kiarash-rgr/Two-Stage-Gearbox-Shaft-Design/final MED project report.pdf

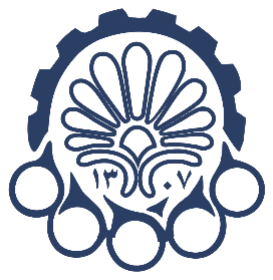
[picture p1: figure]

### دانشگاه صنعتی امیر کبیر )پلی تکنیک تهران(

## پروژهی درس طراحی اجزا :1

### طراحی شفت

استاد: دکتر علی عظیمی
تدریس یار: دکتر مازیار عسکری

گردآورندگان:
ماهک مهدی پور
40226084
کیارش روی گر
40226406
تاریخ تحویل:
1404/11/18

نیمسال اول سال تحصیلی ) 1404-1405(

فهرست مطالب
طرح مسئله 6 |
محاسبات شفت چهارم | 2⁵

فهرست شکلها

شکل -7 نمودار های ممان خمشی و برش در نرم افزار متلب | ۱⁵
شکل -8 layout اولیه از شکل کلی شفت با رعایت تثبیت کننده ها | ۱⁵
شکل -15 نمای کلی نیرو های وارده بر شفت شماره چهار | 2⁵
شکل -27 نقشه فریم بیس | 4⁵

فهرست جداول

جدول -17 نیرو های وارده بر شفت چهار | 2⁵

## طرح مسئله

در پروژههای صنعتی و ساختمانی، سیستم های باالبر نقش اساسی در جابهجایی عمودی بار با ایمنی و قابلیت اطمینان باال
ایفا میکنند. طراحی صحیح اجزای مکانیکی این سیستمها، بهویژه شفت ها و مجموعه انتقال قدرت، تأثیر مستقیمی بر عملکرد، عمر کاری و ایمنی کل سامانه دارد. ازاینرو، تحلیل مهندسی دقیق بارگذاری ها، انتخاب مناسب اجزا و رعایت معیارهای طراحی استاتیکی و خستگی، از الزامات اساسی در فرآیند طراحی محسوب میشود.

در این پروژه، یک باالبر ساختمانی در شرایط پایا مورد بررسی قرار میگیرد که وظیفه انتقال عمودی بار را با سرعت ثابت ۳۳ متر بر ثانیه بر عهده دارد. بار منتقلشده شامل 225 عدد آجر با جرم 2 کیلوگرم برای هر آجر است. توان مورد نیاز این سامانه توسط یک الکتروموتور با سرعت نامی 1600 دور بر دقیقه تأمین شده و از طریق یک سیستم انتقال قدرت شامل چهار شفت، سه جفت چرخ دنده و یک پولی به کابل باالبر منتقل میشود.

هدف اصلی این پروژه، طراحی مهندسی شفتها و اجزای مرتبط در سیستم انتقال قدرت باالبر است؛ بهگونه ای که ضمن تأمین توان و گشتاور مورد نیاز، الزاماتس استحکام، خستگی، ایمنی و قابلیت ساخت نیز برآورده شوند. در این راستا، محاسبه توان مورد نیاز، تحلیل نیروها و گشتاورها، تعیین مقاطع بحرانی شفتها، انتخاب قطر مناسب بر اساس معیارهای طراحی، و در نهایت ارائه نقشه های ساخت و مدلهای CAD از جمله مراحل اساسی این پروژه به شمار میآیند.

## اطالعات تکمیلی مسئله

- در این گیربکس از چرخدنده های ساده )gear spur )با زاویه فشار 20 درجه استفاده شده است.
- بلبرینگ ها از نوع groove deep و از سری 02 میباشند
- جنس شفت از نوع Drawn Cold 1040 AISI با سطح نهایی ماشینکاری است.
- طراحی خستگی و محاسبه قطر های نقاط بحرانی با معیار سادربرگ

1
و ضریب اطمینان اولیه ۳ انجام شده است.
- محاسبه قطر های نقاط بحرانی با استفاده از تحلیل استاتیکی با معیار ترسکا

2
با ضریب اطمینان ۳ انجام شده است.
- ضریب اطمینان مورد نیاز در نقاط جاخار برابر 4 میباشد.
- مقادیر 1L و 2L مشخص شده در شکل 1 به ترتیب : 270 و 1۳0 میلی متر است.

جدول -1 ابعاد چرخدندهها
| | چرخدنده قطر)mm )پهنا )mm )
30 | 50 | G1
30 | 200 | G2
35 | 60 | G3
35 | 150 | G4
40 | 70 | G5
40 | 280 | G6

1 Soderberg
2 Tresca

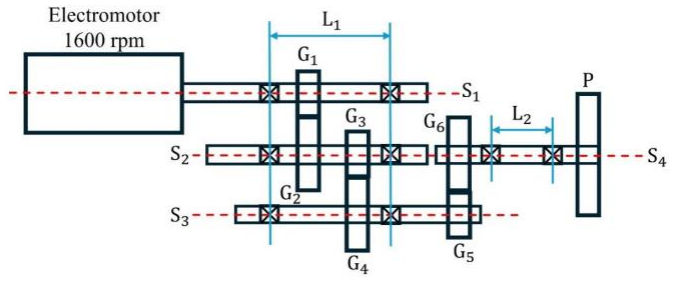
[picture p2: figure]

شکل -1 طرح کلی سیستم انتقال قدرت )نما از باالی سیستم(

## محاسبات اولیه

محاسبه قطر پولی

DG1

=50 mm ; DG2

=200 mm ; DG3

=60 mm ; DG4

=150 mm ; DG5

=70 mm ; DG6

=280 mm

wS1

=1600 rpm

wS2

= wS1

×

DG1
DG2

→ wS2

= 400 rpm

wS3

= wS2

×

DG3
DG4

→ wS3

=160 rpm

wS4

= wS3

×

DG5
DG6

→ wS4

= 40 rpm

v= r×w
v= 0.347 , wS4= 40 rpm

rpulley=

v
w

→ Dpulley=165.5 mm

محاسبه توان الکترو موتور

F= N × m × g = 225 × 2 × 9.81= 4414.5 N

TS4

= F×

D
2

→ TS4
= 365.52 Nm

TS3

= TS4

×

DG5
DG6

→ TS3

= 91.38 Nm

TS2

=TS3

×

DG3
DG4

→TS2

=36.55 Nm

TS1 = TS2
×

DG1
DG2

→ TS1 = 9.138 Nm

P= Tw
Pmotor= 9.138×1600×2×

π
60

→ Pmotor=1.53 Kw

## محاسبات نهایی

محاسبات شفت اول

ϕ=20◦ , DG1

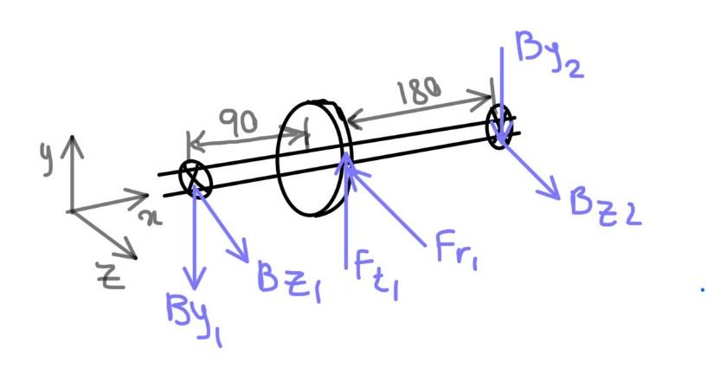
[picture p3: figure]

=50 mm , TS1
= 9.138 Nm

Ft1×

DG1
2

= TS1 → Ft1 = +365.52 N

Fr1 = Ft1×tanφ → Fr1 = −133.04 N

∑Mz = Ft1
× 90 - By2

× 270 = 0 → By2

= -121.84 N

∑My= Fr1
× 90 - Bz2

× 270 = 0 → Bz2
= +44.347 N

∑Fz = -Fr1
+ Bz2

+ Bz1

= 0 → Bz1

= +88.693 N

∑Fy = -By2
+ Ft1
- By1

= 0 → By1

= -243.68 N

جدول -2 نیرو های وارده بر شفت یک

| X(N) | Y(N) | Z(N)
B1 | 0 | -243.68 | +88.693
G1 | 0 | +365.52 | -133.04
B2 | 0 | -121.84 | +44.347

شکل -2 نمای کلی ن یرو های وارده بر شفت شماره ی ک

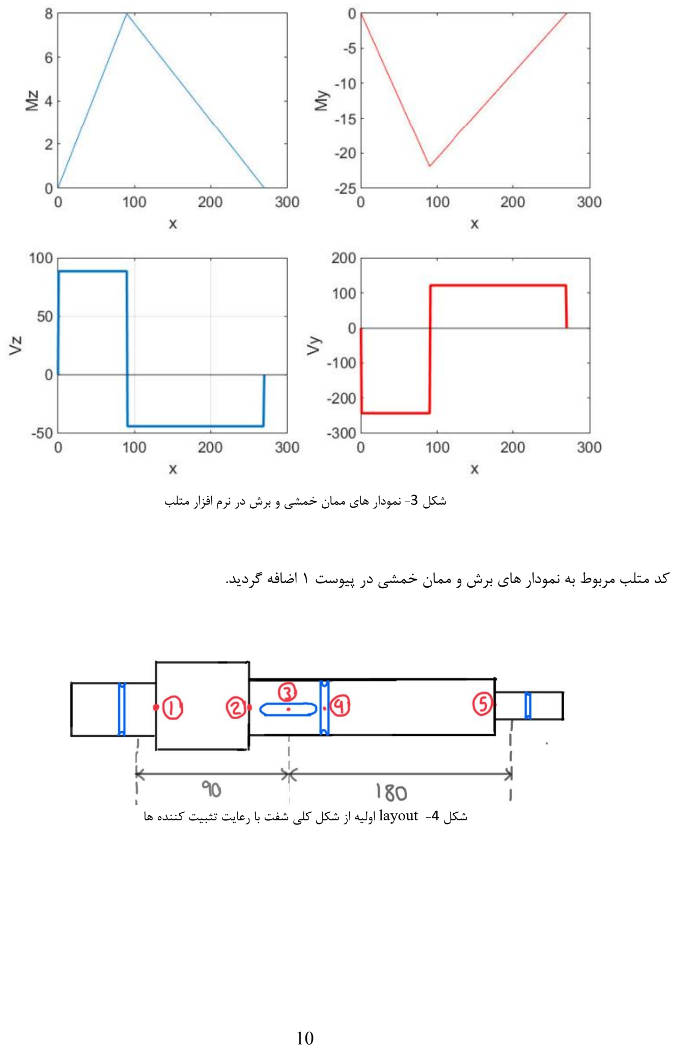
[picture p4: page 10]

کد متلب مربوط به نمودار های برش و ممان خمشی در پیوست 1 اضافه گردید.

شکل -3 نمودار های ممان خمشی و برش در نرم افزار متلب

شکل -4 layout اولیه از شکل کلی شفت با رعایت تثبیت کننده ها

- محاسبه قطر نقاط بحرانی با معیار سادربرگ 3جدول
x(mm) | My (Nm) | Mz (Nm) | Ma (Nm) | Tshaft1 (Nm) | kb | Se (MPa) | D (mm) | d final (mm)
10 | -2.43678 | 0.886667 | 2.59308 | 9.138 | 0.9 | 179.8093 | 12.20333 | 25
75 | -18.2758 | 6.65 | 19.4481 | 9.138 | 0.9 | 179.8093 | 19.74031 | 25
90 | -21.931 | 7.98 | 23.33772 | 9.138 | 0.9 | 179.8093 | 19.98505 | 25
105 | -20.1034 | 7.315 | 21.39291 | 9.138 | 0.9 | 179.8093 | 20.01299 | 25
260 | -1.09655 | 0.399 | 1.166886 | 9.138 | 0.9 | 179.8093 | 10.97021 | 20

جدول -4 محاسبه نقاط بحرانی با معیار ترسکا
x(mm) | My (Nm) | Mz (Nm) | Ma (Nm) | Tshaft1 (Nm) | d (mm)
10 | -2.43678 | 0.886667 | 2.59308 | 9.138 | 8.399846
75 | -18.2758 | 6.65 | 19.4481 | 9.138 | 11.02673
90 | -21.931 | 7.98 | 23.33772 | 9.138 | 11.60716
105 | -20.1034 | 7.315 | 21.39291 | 9.138 | 11.32234
260 | -1.09655 | 0.399 | 1.166886 | 9.138 | 8.314503
3 | در مرحله محاسبه قطر نقاط بحرانی برای محاسبه Se نیاز به تکرار محاسبات
هست که برای این منظور کد پایتون مورد استفاده
در پیوست 1ضافه گردید.
4 | با توجه به ابعاد قطر نهایی بعنوان بیرینگ
اول با مراجعه به استانداد کتاب شیگلی و همچنین SKF بیرینگ با سایز 25 میلی متر
انتخاب شده. با توجه به سایز بیرینگ قطر پله مناسب )قطر ناحیه بین نقطه 1و2( ۳0 میلی متر خواهد بود. برای بیرینگ دوم بیرینگ سایز 20 انتخاب شده که پله مناسب این نوع برابر با 25 میلی متر بوده که با قطری که درنظر گرفتیم مطابقت دارد.

محاسبه مجدد ضریب اطمینان با توجه به قطر های نهایی:

جدول -5 محاسبه مجدد ضریب اطمینان

d final (mm) | sigma a' | sigma m' | 1/nd | nd
25 | 3.46713 | 9.54891 | 0.035467 | 28.19534
25 | 26.00347 | 9.54891 | 0.160802 | 6.218847
25 | 31.20417 | 9.54891 | 0.189725 | 5.27079
25 | 28.60382 | 9.54891 | 0.175263 | 5.705704
20 | 3.047282 | 18.65022 | 0.048558 | 20.594

3
Iteration
4 Bearing

با توجه به قطر بدست آمده برای نقاط بحرانی شفت اول، اندازه جای خار چرخدنده بصورت زیر محاسبه می شود:

قطر شفت در نقطه ای که جاخار چرخدنده قرار می گیرد برابر 25 میلی متر است. با مراجعه به استاندارد مشخصات جاخار:

w=8 mm , h=7 mm , T1=9.138 Nm , d=25 mm , Sy= 490 MPa , Su= 590 MPa

Ls=

4T.nd
wd.Sy

= 1.23 mm

Lp=

4T.nd

hd.Sy, min

= 1.705 mm

با مراجعه به استاندارد، کمترین طول جاخار با توجه به قطر شفت برابر 18 میلیمتر خواهد بود پس طول کلی جاخار به صورت زیر محاسبه خواهد شد.

Ltotal= Lmin+ w = 18+8 = 26 mm
پهنای چرخدنده اول ۳0 میلی متر بوده که بزرگتر از طول جاخار محاسبه شده است و در نتیجه نیازی به اضافه کردن نافی نیست.

اطالعات مربوط به خار فنری:

جدول 6 - مشخصات خارفنری های انتخاب شده
| | | | خار فنری خار فنری جای خار فنری جای خار فنری
d1 | m | d2 | s | d2
20 | 1.3 | 19 | 1.2 | 16.5
25 | 1.3 | 23.9 | 1.2 | 23.2
30 | 1.3 | 28.6 | 1.5 | 27.9

در شکل 5 طراحی شفت شماره 1 با توجه به محاسبات انجام شده مربوط به قطر های نهایی و محاسبات مربوط به جای خار ها، توسط نرم افزار works solid مشاهده می شود. در این شکل محل قرارگیری چرخدنده ها با رنگ آبی و محل قرار گیری بیرینگ ها با رنگ سیاه مشخص شده است. در این طراحی بیرینگ ها بصورت پرسی جا رفته و تثبیت محوری بیرینگ ها و همچنین چرخدنده ها از یک طرف با تکیه بر پله و از طرف دیگر با استفاده از خارفنری، انجام می شود . برای انتخاب سایز بیرینگ و همچنین ارتفاع پله ها از جدول 24 استاندارد سایز بیرینگ که در پیوست 2 آورده شده، استفاده شده است. استاندارد مربوط به ابعاد جای خار فنری و همچنین جای خار مستطیلی به ترتیب در جدول 25 و جدول 26 آورده شده اند که با توجه به قطر در هر قسمت شفت از این استاندارد ها استفاده شده است. با توجه به فرض انجام شده ضمن حل مسئله و انجام محاسبات برای شعاع فیلت ها در هر قسمت نسبت

r
d

0.02= رعایت شده و بر همین اساس طراحی شده اند.

نقشه طراحی شفت 1 در نرم افزار سالید ورک و توضیحات مربوط به تلرانس گذاری به پیوست ۳ اضافه گردید.

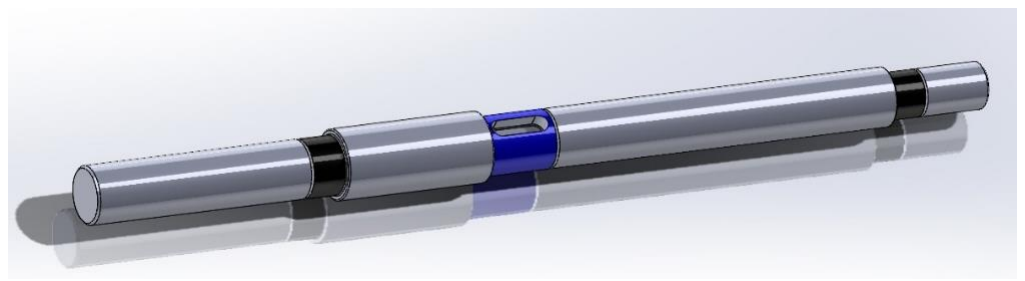
[picture p5: figure]

شکل -5 طراحی نهایی شفت اول در نرم افزار works solid

محاسبات شفت دوم

ϕ= 20◦ , DG3

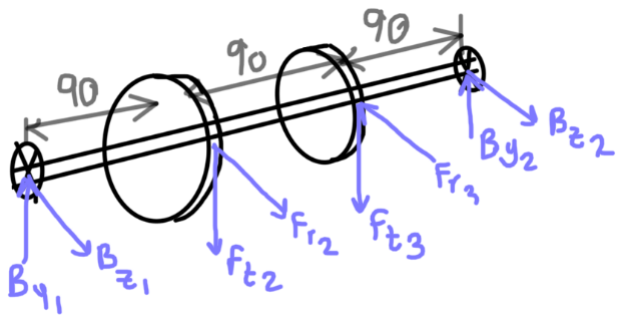
[picture p6: figure]

= 60 mm , Ts2

= 36.55 Nm , Ft2

= -365.52 , Fr2

=+133.04

Ft3

×

DG3
2

= Ts2

→ Ft3

= -1218.33 N

Fr3

=Ft3

×tan(ϕ) → Fr3
= -443.436 N

∑Mz= -Ft2
× 90 - Ft3

× 180 + By2

×270 = 0 → By2

= + 934.06 N

∑My= Fr2
× 90 + Fr3

×180 - Bz2

×270 = 0 → Bz2

= + 251.277 N

∑Fz= +Fr2
+Bz2

+ Bz1

- Fr3

= 0 → Bz1

= +59.119 N

∑Fy = +By2
- Ft2

+ By1

- Ft3

=0 → By1

= +649.79 N

جدول 7 - ن یرو های وارده بر شفت دو

| X(N) | Y(N) | Z(N)
B1 | 0 | +649.79 | +59.119
G2 | 0 | -365.52 | +133.04
G3 | 0 | -1218.33 | -443.436
B2 | 0 | +934.06 | +251.277

شکل -6 نمای کلی ن یرو های وارده بر شفت شمار ه دو

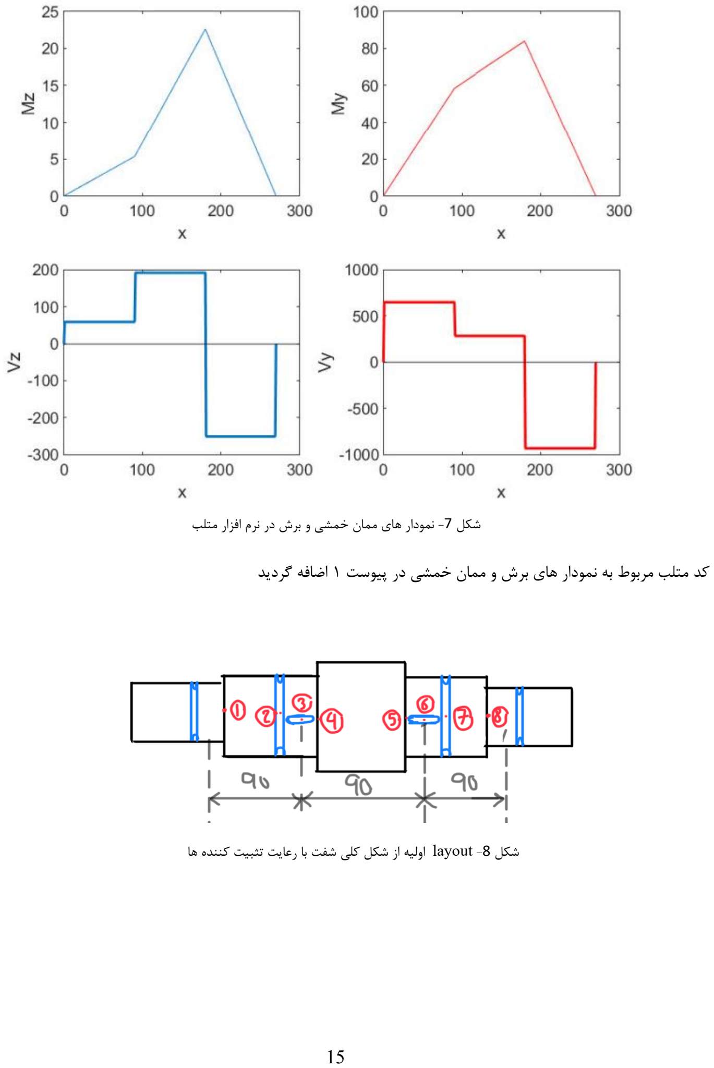
[picture p7: page 15]

کد متلب مربوط به نمودار های برش و ممان خمشی در پیوست 1 اضافه گردید

شکل -8 layout اولیه از شکل کلی شفت با رعا یت تثبیت کننده ها

شکل -7 نمودار های ممان خمشی و برش در نرم افزار متلب

جدول -8 محاسبه قطر نقاط بحرانی بر اساس معیار سادربرگ
x (mm) | My (Nm) | Mz (Nm) | Ma (Nm) | Tshaft2 (Nm) | kb | Se (MPa) | d (mm) | dfinal(mm)
10 | 6.497889 | 0.591222 | 6.52473 | 36.55 | 0.8543 | 170.673 | 18.2213 | 30
75 | 48.73417 | 4.434167 | 48.93548 | 36.55 | 0.8543 | 170.673 | 27.36604 | 35
90 | 58.481 | 5.321 | 58.72257 | 18.275 | 0.8543 | 170.673 | 27.41883 | 35
105 | 62.745 | 8.206333 | 63.27937 | 36.55 | 0.8543 | 170.673 | 29.95972 | 35
162.5 | 79.23247 | 19.35136 | 81.56138 | 36.55 | 0.8543 | 170.673 | 32.27017 | 35
180 | 84.065 | 22.618 | 87.05457 | 18.275 | 0.8543 | 170.673 | 30.9853 | 35
197.5 | 67.252 | 18.092 | 69.64303 | 36.55 | 0.8543 | 170.673 | 30.33451 | 35
260 | 8.4065 | 2.2615 | 8.705379 | 36.55 | 0.8543 | 170.673 | 18.25294 | 30

جدول -9 محاسبه قطر نقاط بحرانی بر اساس معیار ترسکا
x (mm) | My (Nm) | Mz (Nm) | Ma (Nm) | Tshaft2 (Nm) | d (mm)
10 | 6.497889 | 0.591222 | 6.52473 | 36.55 | 13.23168
75 | 48.73417 | 4.434167 | 48.93548 | 36.55 | 15.61989
90 | 58.481 | 5.321 | 58.72257 | 18.275 | 15.65578
105 | 62.745 | 8.206333 | 63.27937 | 36.55 | 16.58216
162.5 | 79.23247 | 19.35136 | 81.56138 | 36.55 | 17.7333
180 | 84.065 | 22.618 | 87.05457 | 18.275 | 17.70519
197.5 | 67.252 | 18.092 | 69.64303 | 36.55 | 16.99355
260 | 8.4065 | 2.2615 | 8.705379 | 36.55 | 13.28429
5 | در مرحله محاسبه قطر نقاط بحرانی برای محاسبه Se نیاز به تکرار محاسبات
هست که برای این منظور کد پایتون مورد استفاده
در پیوست 1 اضافه گردید.

با توجه به ابعاد نهایی برای شفت دوم بعنوان بیرینگ اول با مراجعه به استانداد بیرینگ موجود در کتاب شیگلی و همچنین SKF بیرینگ با سایز ۳0 میلی متر انتخاب شد که بر اساس آن پله مناسب برای قسمت بعدی شفت ۳5 میلی متری خواهد بود که همچنین توجه داریم قطر مناسبی برای قرار دادن چرخدنده شماره 2 باشد. با در نظر گرفتن قطر چرخدنده های 2 و ۳ پله مناسب برای تثبیت محوری این دو چرخدنده را 42 میلی متر در نظر می گیریم. برای بیرینگ دوم با توجه به اینکه محل قرار گیری چرخدنده شماره ۳ پله ای با قطر ۳5 برای تثبیت بیرینگ دوم خواهد بود سایز بیرینگ دوم را ۳0 در نظر می گیریم.

5
Iteration

محاسبه مجدد ضریب اطمینان با توجه به قطر های نهایی:

جدول -10 محاسبه مجدد ضریب اطمینان
dfinal | sigma a' | sigma m' | 1/nd | nd
30 | 5.048623 | 22.10275 | 0.067043 | 14.91581
35 | 23.84481 | 13.91893 | 0.163302 | 6.123627
35 | 28.61377 | 6.959466 | 0.179448 | 5.572635
35 | 30.83417 | 13.91893 | 0.204254 | 4.895873
35 | 39.74245 | 13.91893 | 0.256449 | 3.899416
35 | 42.41912 | 6.959466 | 0.260336 | 3.84119
35 | 33.93499 | 13.91893 | 0.222422 | 4.495961
30 | 6.735939 | 22.10275 | 0.076929 | 12.99896

با توجه به قطر بدست آمده برای نقاط بحرانی شفت دوم ، اندازه جا خار چرخدنده بصورت زیر محاسبه می شود:

قطر شفت در نقطه ای که جاخار چرخدنده 3G و 2G قرار می گیرند برابر ۳5 میلی متر است. با مراجعه به استاندارد مشخصات جاخار:

w=10 mm , h=8 mm , T2=36.55 Nm , d=35mm , Sy=490 , Su=590

Ls=

4T.nd
wd.Sy

= 2.83 mm

Lp=

4T.nd

hd.Sy, min

= 4.262 mm

با مراجعه به استاندارد، کمترین طول جاخار با توجه به قطر شفت برابر 20 میلیمتر خواهد بود پس طول کلی جاخار به صورت زیر محاسبه خواهد شد.

Ltotal= Lmin+ w = 20+10=30mm
پهنای چرخدنده 2G، ۳0 میلی متر بوده که دقیقا برابر طول جاخار محاسبه شده است این اتفاق موجب چسبیدن جاخار به پله می شود که با تمرکز تنش طراحی را نامناسب می کند. در نتیجه برای رفع این مشکل برای چرخدنده 2G نافی میذاریم.

پهنای چرخدنده 3G، ۳5 میلی متر بوده که بزرگتر از طول جاخار محاسبه شده است در نتیجه نیازی به اضافه کردن نافی نیست.

اطالعات مربوط به خار فنری پیوست -2 جدول :25

جدول 11 - مشخصات خارفنری های انتخاب شده

| | | | خار فنری خار فنری جای خار فنری جای خار فنری
d1 | M | d2 | s | d2
30 | 1.6 | 28.6 | 1.2 | 27.9
35 | 1.6 | 33 | 1.2 | 32.2

در شکل شکل 9 طراحی شفت شماره 2 با توجه به محاسبات انجام شده مربوط به قطر های نهایی و محاسبات مربوط به جای خار ها، توسط نرم افزار works solid مشاهده می شود. در این شکل محل قرارگیری چرخدنده ها با رنگ آبی و محل قرار گیری بیرینگ ها با رنگ سیاه مشخص شده است. در این طراحی بیرینگ ها بصورت پرسی جا رفته و تثبیت محوری بیرینگ ها و همچنین چرخدنده ها از یک طرف با تکیه بر پله و از طرف دیگر با استفاده از خارفنری، انجام می شود . برای انتخاب سایز بیرینگ و همچنین ارتفاع پله ها از جدول 24 استاندارد سایز بیرینگ که در پیوست 2 آورده شده، استفاده شده است. استاندارد مربوط به ابعاد جای خار فنری و همچنین جای خار مستطیلی به ترتیب در جدول 25 و جدول 26 آورده شده اند که با توجه به قطر در هر قسمت شفت از این استاندارد ها استفاده شده است. در ابعاد جای خار مستطیلی مربوط به چرخدنده 2G طول جاخار محاسبه شده دقیقا برابر پهنای چرخدنده 2G بوده به همین جهت نیاز به چرخدنده نافی دار خواهیم داشت.

r | با توجه به فرض انجام شده ضمن حل مسئله و انجام محاسبات برای شعاع فیلت ها در هر قسمت نسبت
d

0.0= رعایت شده و بر
همین اساس طراحی شده اند.

نقشه طراحی شفت 2 در نرم افزار سالید ورک و توضیحات مربوط به تلرانس گذاری به پیوست ۳ اضافه گردید.

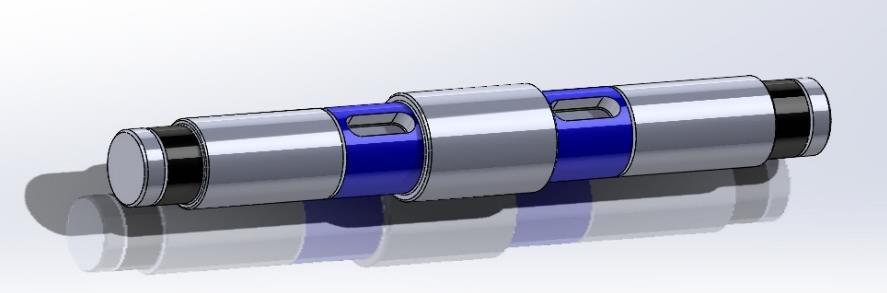
[picture p8: figure]

شکل -9 طراحی نهایی شفت دوم در نرم افزار works solid

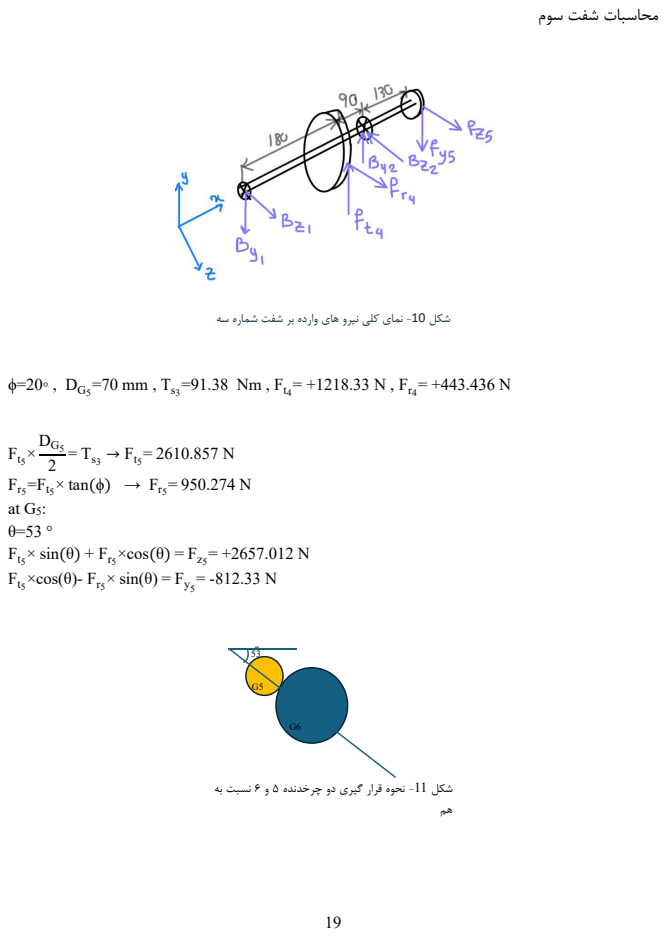
[picture p9: page 19]
× tan(ϕ) → Fr5; × sin(θ) + Fr5; ×cos(θ) = Fz5; ×cos(θ)- Fr5; × sin(θ) = Fy5

محاسبات شفت سوم

شکل -10 نمای کلی ن یرو های وارده بر شفت شماره سه

شکل -11 نحوه قرار گیری دو چرخدنده 5 و 6 نسبت به

∑Mz= +Ft4
×180 + Fy5

×400 + By2

×270 = 0 → By2

= +391.232 N

∑My =Fz5
×400 - Fr4×180 + Bz2

×270 = 0 → Bz2

= -4231.94 N

∑Fz =Bz1
+Fr4-Bz2

+Fz5=0 → Bz1

=+1131.492 N

∑Fy = -By1
+ Ft4

+ By2

- Fy5

= 0 → By1

= -797.232 N

جدول 12 - نیرو های وارده بر شفت سه

| X(N) | Y(N) | Z(N)
B1 | 0 | -797.232 | +1131.492
G4 | 0 | +1218.33 | +443.436
G5 | 0 | -812.33 | +2657.012
B2 | 0 | +391.232 | -4231.94

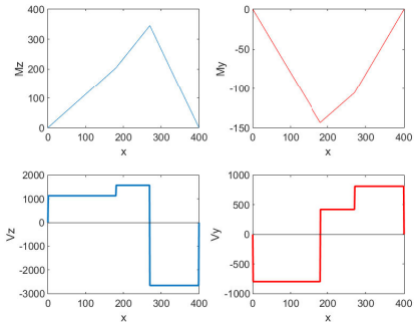
[picture p10: figure]

کد متلب مربوط به نمودار های برش و ممان خمشی در پیوست 1 اضافه گردید

شکل -12 نمودار های ممان خمشی و برش در نرم افزار متلب

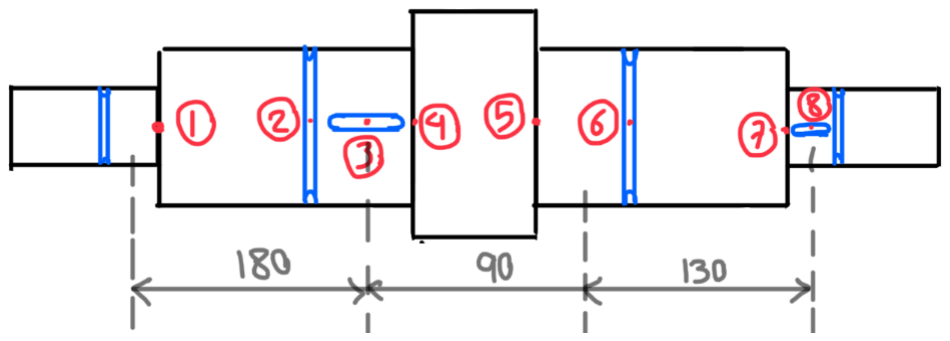
[picture p11: figure]

جدول -13 محاسبه قطر نقاط بحران ی بر اساس معیار سادربرگ

x (mm) | My (Nm) | Mz (Nm) | Ma (Nm) | Tshaft1 (Nm) | kb | Se (MPa) | d (mm) | dfinal (mm)
10 | -7.97222 | 11.315 | 13.84144 | 91.38 | 0.852873 | 170.3939 | 24.23044 | 45
163 | -129.947 | 184.4345 | 225.6155 | 91.38 | 0.852873 | 170.3939 | 44.54178 | 52
180 | -143.5 | 203.67 | 249.146 | 45.69 | 0.852873 | 170.3939 | 43.91017 | 52
198 | -135.92 | 232.0188 | 268.8996 | 91.38 | 0.852873 | 170.3939 | 47.62832 | 52
260 | -109.811 | 329.6647 | 347.4727 | 91.38 | 0.852873 | 170.3939 | 51.54434 | 60
280 | -97.4768 | 318.8434 | 333.4109 | 91.38 | 0.852873 | 170.3939 | 50.27216 | 60
380 | -16.2461 | 53.14031 | 55.56822 | 91.38 | 0.852873 | 170.3939 | 30.92461 | 35
400 | 0 | 0 | 0 | 45.69 | 0.852873 | 170.3939 | 16.13053 | 35

جدول -14 محاسبه قطر نقاط بحران ی بر اساس معیار ترسکا

x (mm) | My (Nm) | Mz (Nm) | Ma (Nm) | Tshaft1 (Nm) | d (mm)
10 | -7.97222 | 11.315 | 13.84144 | 91.38 | 17.9325
163 | -129.947 | 184.4345 | 225.6155 | 91.38 | 24.7647
180 | -143.5 | 203.67 | 249.146 | 45.69 | 25.09539
198 | -135.92 | 232.0188 | 268.8996 | 91.38 | 26.07088
260 | -109.811 | 329.6647 | 347.4727 | 91.38 | 28.19655
280 | -97.4768 | 318.8434 | 333.4109 | 91.38 | 27.8367
380 | -16.2461 | 53.14031 | 55.56822 | 91.38 | 18.82671
400 | 0 | 0 | 0 | 45.69 | 14.17932
6 | در مرحله محاسبه قطر نقاط بحرانی برای محاسبه Se نیاز به تکرار محاسبات
هست که برای این منظور کد پایتون مورد استفاده در پیوست 1 اضافه گردید.

6
Iteration

شکل -13 layout اولیه از شکل کلی شفت با رعا یت تثبیت کننده ها

با توجه به ابعاد نهایی برای شفت سوم بعنوان بیرینگ اول با مراجعه به استانداد بیرینگ موجود در کتاب شیگلی و همچنین SKF بیرینگ سایز 45 انتخاب شده ، پله مناسب برای این نوع بیرینگ با توجه به استاندارد 52 میلی متر بوده که در واقع این قسمت محل قرارگیری چرخدنده 4G با قطر 70 میلی متر نیز خواهد بود . از طرف دیگر برای بیرینگ دوم که با توجه به محاسبات قطر مینیمم مناسب 52 میلی متر محاسبه شده، بیرینگ سایز 60 در نظر گرفته شده و پله مناسب این نوع بیرینگ 70 میلی متر خواهد بود ، قابل توجه است که قسمتی از شفت که برای تثبیت محوری بیرینگ دوم بعنوان پله قرار دارد برای تثبیت محوری چرخدنده 4G نیز استفاده می شود.

محاسبه مجدد ضریب اطمینان با توجه به قطر های نهایی:

جدول -15 محاسبه مجدد ضری ب اطمینان
dfinal | sigma a' | sigma m' | 1/nd | nd
45 | 3.17335 | 16.3733 | 0.046375 | 21.56336
52 | 33.52225 | 10.61118 | 0.214719 | 4.657253
52 | 37.01843 | 5.305592 | 0.226245 | 4.419995
52 | 39.95345 | 10.61118 | 0.252462 | 3.960993
60 | 33.60788 | 6.907487 | 0.208944 | 4.785972
60 | 32.24781 | 6.907487 | 0.200962 | 4.976064
35 | 27.07675 | 34.79924 | 0.217889 | 4.589503
35 | 0 | 17.39962 | 0.029491 | 33.90879

با توجه به قطر بدست آمده برای نقاط بحرانی شفت سوم، اندازه جا خار چرخدنده بصورت زیر محاسبه می شود:

قطر شفت در نقطه ای که جاخار چرخدنده 4G قرار می گیرد برابر 52 میلی متر است. با مراجعه به استاندارد مشخصات جاخار:
w=18 mm , h=10 mm , T3= 91.38 Nm , d=52 mm , Sy=490 MPa , Su=590 MPa

Ls=

4T.nd
wd. Sy

= 2.65 mm

Lp=

4T.nd

hd. Sy, min

= 5.74 mm

با مراجعه به استاندارد کمترین طول جاخار با توجه به قطر شفت برابر 45 میلیمتر خواهد بود پس طول کلی جاخار به صورت زیر محاسبه خواهد شد.

L(total) = L(min.) + w = 45 + 18 = 63 mm
پهنای چرخدنده 4G، ۳5 میلی متر بوده که کمتر از طول جاخار محاسبه شده است در نتیجه برای رفع این مشکل برای چرخدنده 4G نافی میذاریم.

قطر شفت در نقطه ای که جاخار چرخدنده 5G قرار می گیرد برابر ۳5 میلی متر است. با مراجعه به استاندارد مشخصات جاخار:
w = 10 mm , ℎ = 8 mm , T3 = 91.38 Nm , d = 52mm , Sy = 490 , Su = 590

Ls =

4T.nd
wd.Sy

= 7.07 mm

Lp =

4T.nd ℎd.Symin | = 10.66 mm

با مراجعه به استاندارد، کمترین طول جاخار با توجه به قطر شفت برابر 20 میلیمتر خواهد بود پس طول کلی جاخار به صورت زیر محاسبه خواهد شد:

Ltotal= Lmin+ w = 20+10 = 63 mm

پهنای چرخدنده 5G، 40 میلی متر بوده که بزرگتر از طول جاخار محاسبه شده است در نتیجه نیازی به اضافه کردن نافی نیست.

اطالعات مربوط به خار فنری پیوست -2 جدول :25

| جدول -16 مشخصات خارفنری های انتخاب شده
| | | | خار فنری خار فنری جای خار فنری جای خار فنری
d1 | m | d2 | s | d2
45 | 1.85 | 42.5 | 1.75 | 41.5
50 | 2.15 | 47 | 2 | 45.8
35 | 1.6 | 33 | 1.5 | 32.2
60 | 2.15 | 57 | 2 | 55.8

در شکل 14 طراحی شفت شماره ۳ با توجه به محاسبات انجام شده مربوط به قطر های نهایی و محاسبات مربوط به جای خار ها، توسط نرم افزار works solid مشاهده می شود. در این شکل محل قرارگیری چرخدنده ها با رنگ آبی و محل قرار گیری بیرینگ ها با رنگ سیاه مشخص شده است. در این طراحی بیرینگ ها بصورت پرسی جا رفته و تثبیت محوری بیرینگ ها و همچنین چرخدنده ها از یک طرف با تکیه بر پله و از طرف دیگر با استفاده از خارفنری، انجام می شود . برای انتخاب سایز بیرینگ و همچنین ارتفاع پله ها از جدول 24 استاندارد سایز بیرینگ که در پیوست 2 آورده شده، استفاده شده است. استاندارد مربوط به ابعاد جای خار فنری و همچنین جای خار مستطیلی به ترتیب در جدول 25 و جدول 26 آورده شده اند که با توجه به قطر در هر قسمت شفت از این استاندارد ها استفاده شده است. در ابعاد جای خار مستطیلی مربوط به چرخدنده 4G طول جاخار محاسبه شده از پهنای چرخدنده بیشتر بوده به همین جهت نیاز به چرخدنده نافی دار خواهیم داشت.

r | با توجه به فرض انجام شده ضمن حل مسئله و انجام محاسبات برای شعاع فیلت ها در هر قسمت نسبت
d

0.02= رعایت شده و
بر همین اساس طراحی شده اند.

نقشه طراحی شفت ۳ در نرم افزار سالید ورک و توضیحات مربوط به تلرانس گذاری به پیوست ۳ اضافه گردید.

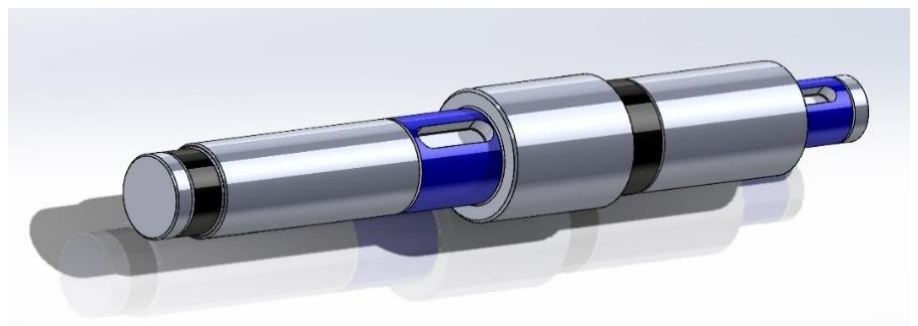
[picture p12: figure]

شکل -14 طراحی نهایی شفت سوم در نرم افزار works solid

محاسبات شفت چهارم

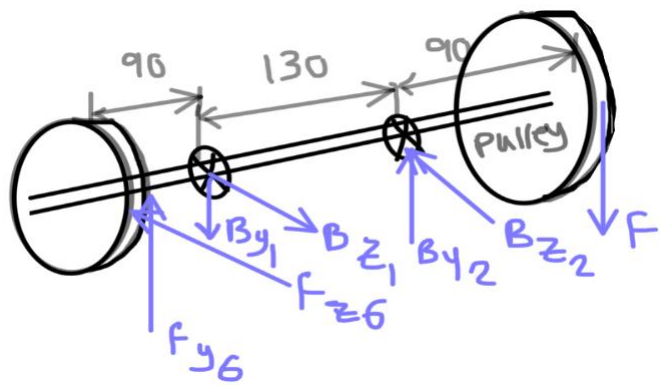
[picture p13: figure]

φ = 20°, DG6 = 280mm , Ts4 = 365.52 Nm , Fz6 = +2657.012 N , Fy6

= −812.33 N

for pulley:

F = N × m × g = 225 × 2 × 9.81 = 4414.5 N

∑Mz = −F × 90 − Fy6
× 90 + By2

× 130 = 0 → By2

= +8033.075 N

∑My = −Fy6
× 90 + Bz2 × 130 = 0 → Bz2 = −1839.47 N

∑Fz = Bz1 − Bz2 − Fz6 = 0 → Bz1 = +4496.482 N

∑Fy = −By1
− F + By2

+ Fy6

= 0 → By1

= −4430.905 N

جدول -17 ن یرو های وارده بر شفت چهار

| X(N) | Y(N) | Z(N)
B1 | 0 | -4430.905 | +4496.482
G6 | 0 | +812.33 | -2657.012
P | 0 | -4414.5 | 0
B2 | 0 | +8033.075 | -1839.47

شکل -15 نمای کلی ن یرو های وارده بر شفت شماره چهار

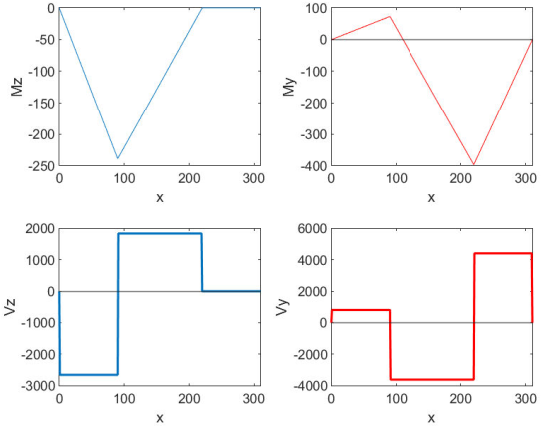
[picture p14: figure]

شکل -16 نمودار ممان خمشی و برش در نرم افزار متلب

کد متلب مربوط به نمودار های برش و ممان خمشی در پیوست 1 اضافه گردید

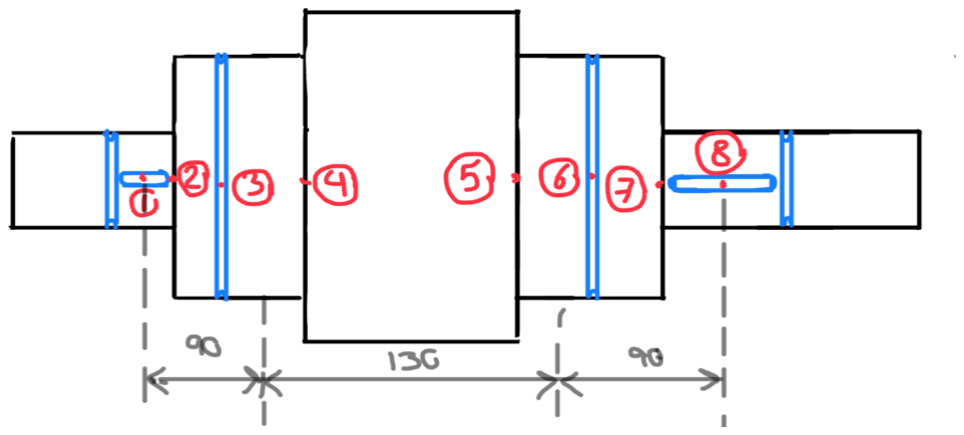
[picture p15: figure]

جدول -18 محاسبه قطر نقاط بحران ی بر اساس معیار سادربرگ

x | My (N.m) | Mz (N.m) | Ma (N.m) | Tshaft1 (Nm) | kb | Se (MPa) | d (mm) | dfinal
0 | 0 | 0 | 0 | 182.76 | 0.809495 | 161.7275 | 25.60563 | 45
20 | 16.24667 | -53.1402 | 55.56831 | 365.52 | 0.809495 | 161.7275 | 38.7252 | 52
80 | 64.98667 | -212.561 | 222.2733 | 365.52 | 0.809495 | 161.7275 | 48.44042 | 52
100 | 36.92431 | -220.736 | 223.8031 | 365.52 | 0.809495 | 161.7275 | 49.76837 | 52
210 | -361.119 | -18.3945 | 361.5873 | 365.52 | 0.809495 | 161.7275 | 56.11151 | 55
230 | -353.16 | 0 | 353.16 | 365.52 | 0.809495 | 161.7275 | 54.64234 | 55
295 | -66.2175 | 0 | 66.2175 | 365.52 | 0.809495 | 161.7275 | 39.6216 | 32
310 | 0 | 0 | 0 | 182.76 | 0.809495 | 161.7275 | 25.60563 | 32

جدول -19 محاسبه قطر نقاط بحران ی بر اساس معیار ترسکا

x | My (N.m) | Mz (N.m) | Ma (N.m) | Tshaft1 (Nm) | d (mm)
0 | 0 | 0 | 0 | 182.76 | 22.50828
20 | 16.24667 | -53.1402 | 55.56831 | 365.52 | 28.46685
80 | 64.98667 | -212.561 | 222.2733 | 365.52 | 29.88554
100 | 36.92431 | -220.736 | 223.8031 | 365.52 | 29.90408
210 | -361.119 | -18.3945 | 361.5873 | 365.52 | 31.77448
230 | -353.16 | 0 | 353.16 | 365.52 | 31.65265
295 | -66.2175 | 0 | 66.2175 | 365.52 | 28.51169
310 | 0 | 0 | 0 | 182.76 | 22.50828
7 | در مرحله محاسبه قطر نقاط بحرانی برای محاسبه Se نیاز به تکرار محاسبات
هست که برای این منظور کد پایتون مورد استفاده در پیوست 1 اضافه گردید.

7
Iteration

شکل -17 layout اولیه از شکل کلی شفت با رعا یت تثبیت کننده ها

با توجه به ابعاد نهایی برای شفت چهارم بعنوان بیرینگ اول و دوم با مراجعه به استانداد بیرینگ موجود در کتاب شیگلی و همچنین SKF، بیرینگ سایز 60 را انتخاب می کنیم ، محل قرار گیری این بیرینگ در واقع بعنوان پله ای استفاده شده برای تثبیت محوری چرخدنده 6G. الزم به ذکر است که پله مناسب برای این نوع بیرینگ 70 میلی متر میباشد.

محاسبه مجدد ضریب اطمینان با توجه به قطر های نهایی:

جدول -20 محاسبه مجدد ضریب اطمینان
dfinal | sigma a' | sigma m' | 1/nd | nd
45 | 0 | 32.74661 | 0.055503 | 18.01713
52 | 8.256412 | 42.44473 | 0.122992 | 8.130637
52 | 33.02565 | 42.44473 | 0.276146 | 3.621276
52 | 33.25295 | 42.44473 | 0.277551 | 3.602939
55 | 45.40455 | 35.87119 | 0.341546 | 2.927865
55 | 44.34632 | 35.87119 | 0.335003 | 2.985052
32 | 42.21794 | 182.131 | 0.56974 | 1.755186
32 | 0 | 91.06551 | 0.154348 | 6.478853

با توجه به قطر بدست آمده برای نقاط بحرانی شفت سوم، اندازه جا خار چرخدنده بصورت زیر محاسبه می شود:

قطر شفت در نقطه ای که جاخار چرخدنده 6G قرار می گیرد برابر 40 میلی متر است. با مراجعه به مراجعه به جدول -26 استاندارد اندازه جای خار های مستطیلی

در پیوست ،2 استاندارد مشخصات جاخار:
w=12 mm , h=8 mm , Ts4

=365.52 Nm , d=40mm , Sy=490 , Su=590

Ls =

4T.nd
wd.Sy = 20.65 mm

Lp =

4T.nd
ℎd.Symin

= 37.3 mm

با مراجعه به جدول -26 استاندارد اندازه جای خار های مستطیلی

، کمترین طول جاخار با توجه به قطر شفت برابر 28 میلیمتر خواهد بود پس طول کلی جاخار به صورت زیر محاسبه خواهد شد.

Ltotal=Lmin+w=37.3+12=49.3 mm

پهنای چرخدنده 6G 40 میلی متر بوده که کمتر از طول جاخار محاسبه شده است در نتیجه برای رفع این مشکل برای چرخدنده 6G نافی میذاریم.

با توجه به قطر بدست آمده برای نقاط بحرانی شفت چهارم اندازه جا خار پولی بصورت زیر محاسبه می شود:

قطر شفت در نقطه ای که جاخار پولی قرار می گیرد برابر 40 میلی متر است. با مراجعه به استاندارد مشخصات جاخار

w=12 mm , h=8 mm , T | : s4

=365.52 Nm , d=40mm , Sy=490 MPa , Suc=270 MPa

Ls =

4T.nd
wd.Sy

= 45.13 mm

Lp=

4T.nd

hd.Symin

= 37.3 mm

در نتیجه طول نهایی جاخار پولی بصورت زیر محاسبه خواهد شد.

Ltotal= Lmin+ w = 45.13 + 12 = 57.13 mm

اطالعات مربوط به خار فنری با مراجعه به پیوست -2 جدول 25 :

جدول -21 مشخصات خارفنری های انتخاب شده
| | | | خار فنری خار فنری جای خار فنری جای خار فنری
d1 | m | d2 | s | d2
40 | 1.85 | 37.5 | 1.75 | 36.5
60 | 2.15 | 57 | 2 | 55.8

در شکل 18 طراحی شفت شماره 4 با توجه به محاسبات انجام شده مربوط به قطر های نهایی و محاسبات مربوط به جای خار ها، توسط نرم افزار works solid مشاهده می شود. در این شکل محل قرارگیری چرخدنده ها با رنگ آبی ، محل قرار گیری بیرینگ ها با رنگ سیاه و محل قرار گیری پولی با رنگ سبز مشخص شده است. در این طراحی بیرینگ ها بصورت پرسی جا رفته و تثبیت محوری بیرینگ ها و همچنین چرخدنده ها از یک طرف با تکیه بر پله و از طرف دیگر با استفاده از خارفنری، انجام می شود. همچنین برای تثبیت پولی از خار مستطیلی و خارفنری استفاده شده. برای انتخاب سایز بیرینگ و همچنین ارتفاع پله ها از جدول 24 استاندارد سایز بیرینگ که در پیوست 2 آورده شده، استفاده شده است. استاندارد مربوط به ابعاد جای خار فنری و همچنین جای خار مستطیلی به ترتیب در جدول 25 و جدول 26 آورده شده اند که با توجه به قطر در هر قسمت شفت از این استاندارد ها استفاده شده است. در ابعاد جای خار مستطیلی مربوط به چرخدنده 6G طول جاخار محاسبه شده از پهنای این چرخدنده بیشتر بوده به همین جهت نیاز به چرخدنده نافی دار خواهیم داشت.

r | با توجه به فرض انجام شده ضمن حل مسئله و انجام محاسبات برای شعاع فیلت ها در هر قسمت نسبت
d

0.02= رعایت شده و
بر همین اساس طراحی شده اند.

نقشه طراحی شفت 4 در نرم افزار سالید ورک و توضیحات مربوط به تلرانس گذاری به پیوست ۳ اضافه گردید.

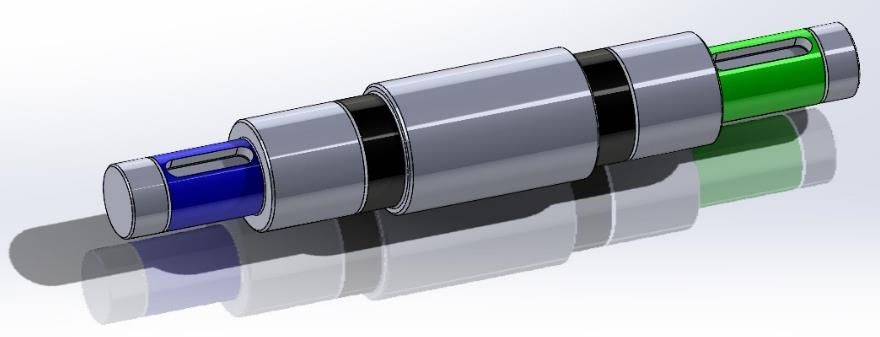
[picture p16: figure]

شکل -18 طراحی نهایی شفت چهارم در نرم افزار works solid

## طراحی پوسته گیربکس

برای طراحی گیربکس با استفاده از اطالعات مربوط به قطر خارجی چرخدنده ها )جدول( و همینطور قطر خارجی بیرینگ ها )جدول(، ابعاد مورد نیاز بدست می آیند. یاتاقان ها از نوع پایه دار)هوزینگی( انتخاب شده و برای اتصال این یاتاقان ها به پوسته گیربکس از پیچ 10M با ارتفاع 20 میلی متر انتخاب شده.

مشکلی که در طراحی گیربکس با آن مواجه هستیم برخورد بیرینگ ها با یکدیگر است. در مواجهه با این مشکل دو راهکار داریم: -1 سایز بیرینگ ها و در نتیجه قطر شفت ها را تغییر دهیم -2 محل قرار گیری بیرینگ ها را اندکی جابجا کنیم. با بررسی سایز بیرینگ های انتخاب شده و کوچکترین قطر محاسبه شده در نقاط بحرانی شفت، نتیجه گیری می شود که تغییر سایز بیرینگ حداکثر یک تا دو سایز میسر بوده که در آخر کمک زیادی به حل مشکل برخورد بیرینگ ها نمی کند. در نتجه باید با راهکار دوم پیش رفت. الزم به ذکر است که با پیشبرد این راهکار دیگر هم راستا بودن بیرینگ شفت ها 1و2و۳ میسر نخواهد بود. سوالی که پیش میاید این است که با افزایش طول و یا جابجایی محل قرارگیری بیرینگ روی شفت آیا تغییری در قطر های طراحی شده پیش میاید یا خیر. برای پاسخ به این سوال شفت سوم را بعنوان نمونه انتخاب کرده سپس محل قرارگیری بیرینگ 2B را به اندازه 20 میلیمتر جابجا می کنیم و در طول پله را افزایش می دهیم. با این کار مجددا محاسبات را از ابتدا برای این شفت انجام می دهیم.

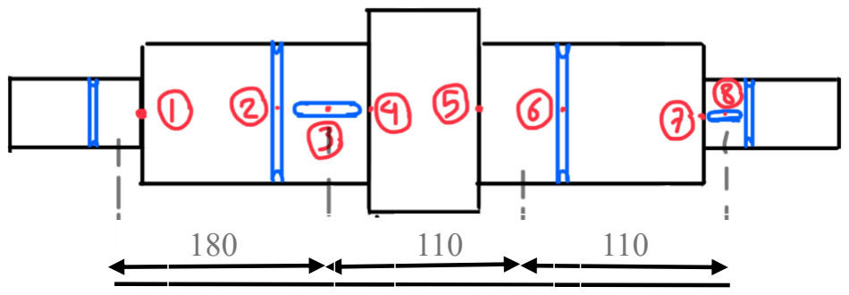
[picture p17: figure]

با استفاده از محاسبات گذشته مربوط به نیرو های چرخدنده ها در شفت ۳ نیروهای وارده بر بیرینگ ها را مجددا محاسبه می کنیم.

Fz5

= +2657.012 N , Fy5

= -812.33 N, Ts3

=91.38 Nm , Ft4

= +1218.33 N , Fr4

= +443.436 N

شکل -19 out lay اولیه اصالح شده شفت سه

∑Mz= +Ft4
×180 + Fy5

×400 + By2

×290 = 0 → By2
= +364.25 N

∑My =Fz5
×400 - Fr4×180 + Bz2

×290 = 0 → Bz2
= -3940.08 N

∑Fz =Bz1
+Fr4-Bz2

+Fz5=0 → Bz1

= +839.632 N

∑Fy = -By1
+ Ft4

+ By2

- Fy5

= 0 → By1

= -770.25 N

جدول 22 - نیرو های وارده بر شفت سه

| X(N) | Y(N) | Z(N)
B1 | 0 | -770.25 | +839.632
G4 | 0 | +1218.33 | +443.436
G5 | 0 | -812.33 | +2657.012
B2 | 0 | +364.25 | -3940.08

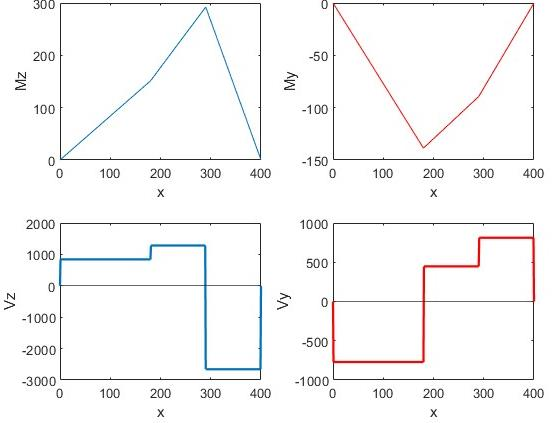
[picture p18: figure]

شکل -20 نمودار ممان خمشی و برش در نرم افزار متلب

کد متلب مربوط به نمودار های برش و ممان خمشی در پیوست 1 اضافه گردید

جدول 23 – محاسبه مجدد قطر در نقاط بحرانی با استفاده از معیار سادربرگ

x | My | Mz | Ma | Tshaft1 | kb | Se | dmin | dfinal
10 | -7.7025 | 8.396333 | 11.39416 | 91.38 | 0.823605 | 164.546 | 23.79619 | 45
163 | -125.551 | 136.8602 | 185.7248 | 91.38 | 0.823605 | 164.546 | 42.43673 | 52
180 | -138.645 | 151.134 | 205.0949 | 45.69 | 0.823605 | 164.546 | 41.75335 | 52
198 | -130.579 | 174.2296 | 217.731 | 91.38 | 0.823605 | 164.546 | 45.15469 | 52
280 | -93.8361 | 279.4408 | 294.7751 | 91.38 | 0.823605 | 164.546 | 49.51721 | 60
300 | -81.2318 | 265.7009 | 277.8409 | 91.38 | 0.823605 | 164.546 | 48.00901 | 60
380 | -16.2456 | 53.14015 | 55.56794 | 91.38 | 0.823605 | 164.546 | 31.17572 | 35
400 | 0 | 0 | 0 | 45.69 | 0.823605 | 164.546 | 16.13053 | 35

با توجه به نتایج بدست آمده از محاسبه مجدد قطر شفت در نقاط بحرانی و همچنین مقایسه با قطر نهایی فرض شده، می توان این نتیجه را گرفت که افزودن طول پله و جلو بردن بیرینگ روی شفت تا حدود 20 میلی متر تغییر چندانی ایجاد نکرده و حتی طراحی ما را محافظه کارانه تر هم می کند. در نتیجه این راهکار می تواند در حل مشکل برخورد یاتاقان ها با یکدیگر موثر باشد.

با استفاده از اطالعات بدست آمده طراحی پوسته گیربکس بصورت زیر انجام می شود.

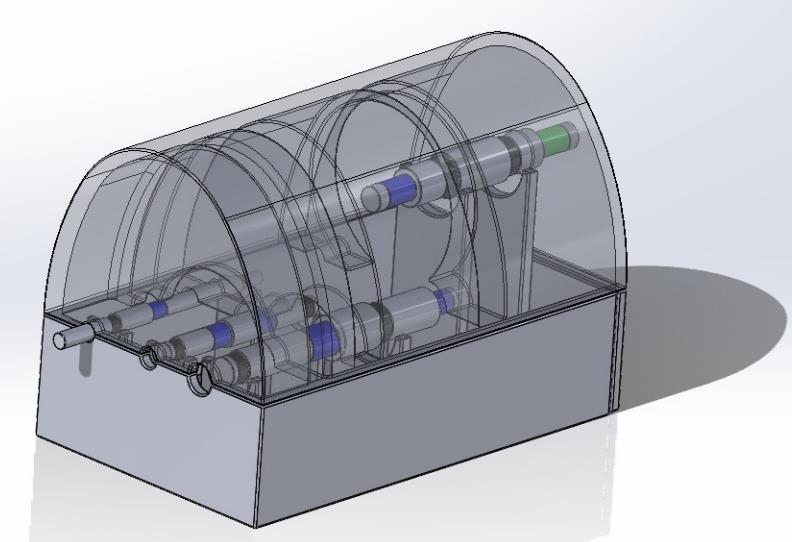
[picture p19: figure]

شکل -21 طراحی کلی پوسته گیربکس

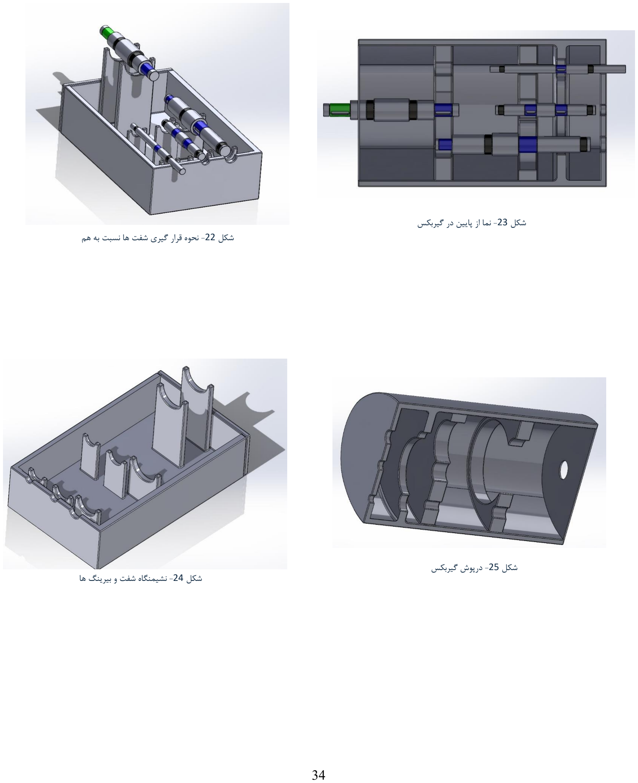
[picture p20: page 34]

شکل -22 نحوه قرار گیری شفت ها نسبت به هم

شکل -23 نما از پایین در گیربکس

شکل -25 درپوش گیربکس
شکل -24 نشیمنگاه شفت و بیرینگ ها

نقشه طراحی پوسته گیربکس به پیوست ۳ اضافه گردید.

## پیوست 1

کد متلب مربوط به رسم نمودار های ممان خمشی و برش

clc;
clear;
% shaft1
x=0:270;
Mz=zeros(size(x));
Vz=zeros(size(x));

for i=1:length(x)
if x(i)==0|| x(i)==270
Vz(i)=0;

elseif x(i)<= 90
Mz(i)=7.98/90 .* x(i);
Vz(i)=+88.693;
elseif x(i)==90
Vz(i)=0;

else
Mz(i)=-7.98/180 .*x(i) + 11.97; Vz(i)=-44.347;
end
end
figure(1)
subplot(2,2,1)
plot(x,Mz);
xlabel('x')
ylabel('Mz')
figure(1)
subplot(2,2,3)
plot(x,Vz ,'LineWidth', 1.5); hold on
yline(0, 'LineWidth', 0.7) xlabel('x')
ylabel('Vz')
% shaft1

grid on

Vy=zeros(size(x));
My=zeros(size(x));
for i=1:length(x)
if x(i)==0|| x(i)==270
Vy(i)=0;
elseif x(i)<=90
Vy(i)=-243.68;
My(i)=-21.931/90 .* x(i);
elseif x(i)==90
Vy(i)=0;

else
My(i)=21.931/180 .*x(i) -32.8965; Vy(i)=121.84;
end
end
figure(1)
subplot(2,2,2)
plot (x,My,'r');
xlabel('x')
ylabel('My')
figure(1)
subplot(2,2,4);
plot (x,Vy,'r','LineWidth', 1.5);

hold on
yline(0, 'LineWidth', 0.7) xlabel('x')
ylabel('Vy')

% shaft2
x=0:270;
Mz=zeros(size(x));
Vz=zeros(size(x));
for i=1:length(x)
if x(i)==0|| x(i)==270
Vz(i)=0;
elseif x(i)<=90
Mz(i)=5.321/90 .* x(i);
Vz(i)=59.119;
elseif x(i)>90 && x(i)<=180 Mz(i)=17.294/90 .*x(i) - 11.97; Vz(i)=192.159;
else
Mz(i)= -22.615/90 .*x(i) + 67.845; Vz(i)=-251.277;
end
end
figure(2)
subplot(2,2,1);
plot(x,Mz);
xlabel('x')
ylabel('Mz')
figure(2)
subplot(2,2,3);
plot(x,Vz,'LineWidth', 1.5); hold on
yline(0, 'LineWidth', 0.7) xlabel('x')
ylabel('Vz')

My=zeros(size(x));
Vy=zeros(size(x));

for i=1:length(x)
if x(i)==0|| x(i)==270
Vz(i)=0;
elseif x(i)<=90
My(i)=58.481/90 .* x(i);
Vy(i)=649.79;
elseif x(i)>90 && x(i)<=180 My(i)=25.584/90 .*x(i) +32.897; Vy(i)=284.27;
else
My(i)= -84.065/90 .*x(i) + 252.195; Vy(i)=-934.06;
end
end
figure(2)
subplot(2,2,2);
plot (x,My,'r');
xlabel('x')
ylabel('My')
figure(2)
subplot(2,2,4);
plot (x,Vy,'r','LineWidth', 1.5); hold on
yline(0, 'LineWidth', 0.7) xlabel('x')
ylabel('Vy')

% shaft3
x=0:400;

Mz=zeros(size(x));
Vz=zeros(size(x));
for i=1:length(x)
if x(i)==0|| x(i)==400
Vz(i)=0;
elseif x(i)<=180
Mz(i)=203.67/180 .* x(i);
Vz(i)=1131.492;
elseif x(i)>=180 && x(i)<270 Mz(i)=141.744/90 .*x(i) - 79.818; Vz(i)=1574.928;
else
Mz(i)= -345.414/130 .*x(i) + 1062.812; Vz(i)=-2657.012;
end
end
figure(3)
subplot(2,2,1);
plot(x,Mz);
xlabel('x')
ylabel('Mz')
figure(3)
subplot(2,2,3);
plot(x,Vz,'LineWidth', 1.5); hold on
yline(0, 'LineWidth', 0.7) xlabel('x')
ylabel('Vz')

My=zeros(size(x));
Vy=zeros(size(x));

for i=1:length(x)
if x(i)==0|| x(i)==400
Vz(i)=0;

elseif x(i)<=180
My(i)=-143.5/180 .* x(i);
Vy(i)=-797.232;
elseif x(i)>180 && x(i)<=270 My(i)=37.9/90 .*x(i) -219.3; Vy(i)=421.098;
else
My(i)= 105.6/130 .*x(i) -324.923; Vy(i)=812.33;
end
end
figure(3)
subplot(2,2,2);
plot (x,My,'r');
xlabel('x')
ylabel('My')
figure(3)
subplot(2,2,4);
plot (x,Vy,'r','LineWidth', 1.5); hold on
yline(0, 'LineWidth', 0.7) xlabel('x')
ylabel('Vy')

% shaft4
x=0:310;
Mz=zeros(size(x));
Vz=zeros(size(x));
for i=1:length(x)
if x(i)==0|| x(i)==220
Vz(i)=0;
elseif x(i)<=90
Mz(i)=-239.131/90 .* x(i);

Vz(i)=-2657.012;
elseif x(i)>=90 && x(i)<220 Mz(i)=239.131/130 .*x(i) - 404.683; Vz(i)=1839.47;
else
Mz(i)= 0;
Vz(i)=0;
end
end
figure(3)
subplot(2,2,1);
plot(x,Mz);
xlabel('x')
ylabel('Mz')
figure(3)
subplot(2,2,3);
plot(x,Vz,'LineWidth', 1.5); hold on
yline(0, 'LineWidth', 0.7) xlabel('x')
ylabel('Vz')

My=zeros(size(x));
Vy=zeros(size(x));

for i=1:length(x)
if x(i)==0|| x(i)==310
Vy(i)=0;

elseif x(i)<=90
My(i)=73.11/90 .* x(i);
Vy(i)=+812.33;
elseif x(i)>90 && x(i)<=220 My(i)=-470.415/130 .*x(i) +398.782; Vy(i)=-3618.575;
else
My(i)= 397.305/90 .*x(i) -1368.495; Vy(i)=4414.5;
end
end
figure(3)
subplot(2,2,2);
plot (x,My,'r');
hold on
yline(0, 'LineWidth', 0.7) xlabel('x')
ylabel('My')
figure(3)
subplot(2,2,4);
plot (x,Vy,'r','LineWidth', 1.5); hold on
yline(0, 'LineWidth', 0.7) xlabel('x')
ylabel('Vy')

%new shaft3
x=0:400;
Mz=zeros(size(x));
Vz=zeros(size(x));
for i=1:length(x)
if x(i)==0|| x(i)==400
Vz(i)=0;
elseif x(i)<=180
Mz(i)=151.134/180 .* x(i); Vz(i)=839.632;
elseif x(i)>=180 && x(i)<290 Mz(i)=141.137/110 .*x(i) -79.817; Vz(i)=1283.068;
else

Mz(i)= -292.271/110 .*x(i) + 1062.8036; Vz(i)=-2657.012;
end
end
figure(3)
subplot(2,2,1);
plot(x,Mz);
xlabel('x')
ylabel('Mz')
figure(3)
subplot(2,2,3);
plot(x,Vz,'LineWidth', 1.5); hold on
yline(0, 'LineWidth', 0.7) xlabel('x')
ylabel('Vz')

My=zeros(size(x));
Vy=zeros(size(x));

for i=1:length(x)
if x(i)==0|| x(i)==400
Vz(i)=0;

elseif x(i)<=180
My(i)=-138.645/180 .* x(i); Vy(i)=-770.25;
elseif x(i)>180 && x(i)<=290 My(i)=49.289/110 .*x(i) -219.299; Vy(i)=448.08;
else
My(i)= 89.356/110 .*x(i) -324.93; Vy(i)=812.33;
end
end
figure(3)
subplot(2,2,2);
plot (x,My,'r');
xlabel('x')
ylabel('My')
figure(3)
subplot(2,2,4);
plot (x,Vy,'r','LineWidth', 1.5); hold on
yline(0, 'LineWidth', 0.7) xlabel('x')
ylabel('Vy')

کد پایتون مربوط به فرایند تکرار محاسبات و بدست آوردن Se و Kb

# Mechanice Design Element!!! # Mahak Mehdipour

# Kiarash Rooygar

importmath

S_y=490
S_E0=590/2.0
K_A=0.832
K_C=1.0
K_E=0.814

defK_b(d_mm: float) -> float: ifd_mm<=2.79:
d_eff=2.79
else:
d_eff=d_mm

if2.79<d_eff<=51.0:
return1.24* (d_eff** (-0.107)) else:
return1.51* (d_eff** (-0.157))

defS_e(d_mm: float, S_e0: float=S_E0, k_a: float=K_A, k_c: float=K_C, k_e: float=K_E) -> float:
base=S_e0*k_a*k_c*k_e
returnbase*K_b(d_mm)

defrange(d_start: float=2.79, d_stop: float=254.0, step: float=0.25): d=d_start
rows= []
whiled<=d_stop+1e-12:
rows.append((d, K_b(d), S_e(d))) d+=step
returnrows

n_d=3
K_f=2.05
K_fs=1.85
# T_m = 9.138

# M_a_s = [2.593112, 16.85505, 23.33772, 20.09637]

defdiameter(M, T, S_e_vraible):
d= ((
((16*n_d) /math.pi) *
(
(math.sqrt(3*(K_fs*T)**2)) /S_y+ (math.sqrt(4*(K_f*M)**2+3*(K_fs*T)**2)) /S_e_vraible )
) ** (1/3)) *10
returnd

defmain(M, T):
rows=range()
print("\tMa()\td(mm)\t\tKb\t\tS_e(MPa)\t\t d(mm)__calc")

Error=1
found=False
d_final_g=float
d_final=float
kb_val_final=float
se_val_final=float
ford, kb_val, se_valinrows[:1000]: d_calc=diameter(M, T, se_val)
ifd- (0.01*d_calc) <d_calc<d+ (0.01*d_calc): ifabs(d-d_calc) <Error:
Error=abs(d-d_calc)
d_final_g=d
d_final=d_calc
kb_val_final=kb_val
se_val_final=se_val
# M_i_final = i

found=True
iffound:
print(f"for {M}: {d_final_g}\t{kb_val_final}\t{se_val_final}\t", d_final) input("\n\nPress Enter to continue...")
print("\n\n")

whileTrue:
T=float(input("Enter the value of T (Torque in Nm): ")) M=float(input("Enter the value of M (Bending Moment in Nm): ")) print()
main(M, T)

## پیوست 2

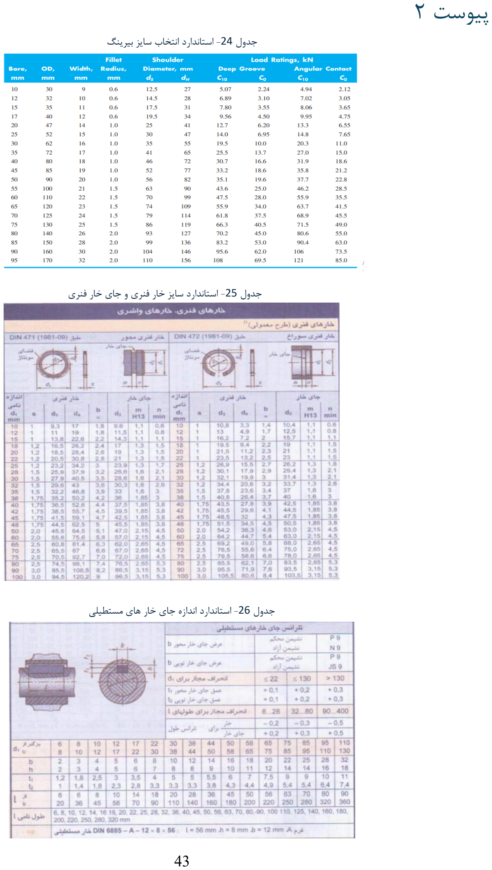
[picture p21: page 43]

جدول -24 استاندارد انتخاب سایز بیرینگ

جدول -26 استاندارد اندازه جای خار های مستطیلی

جدول -25 استاندارد سایز خار فنری و جای خار فنری

## پیوست ۳

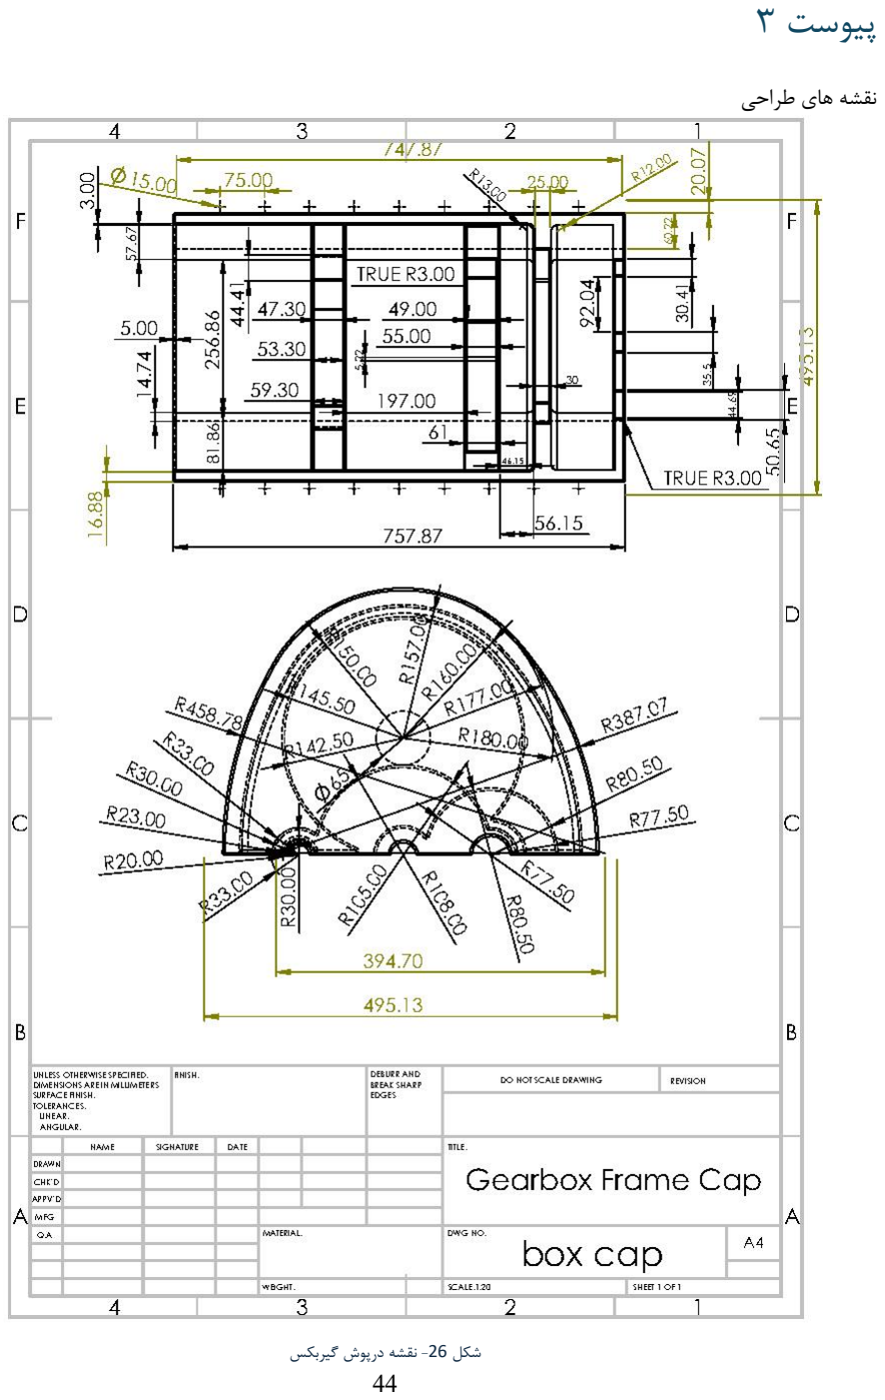
[picture p22: page 44]

نقشه های طراحی

شکل -26 نقشه درپوش گیربکس

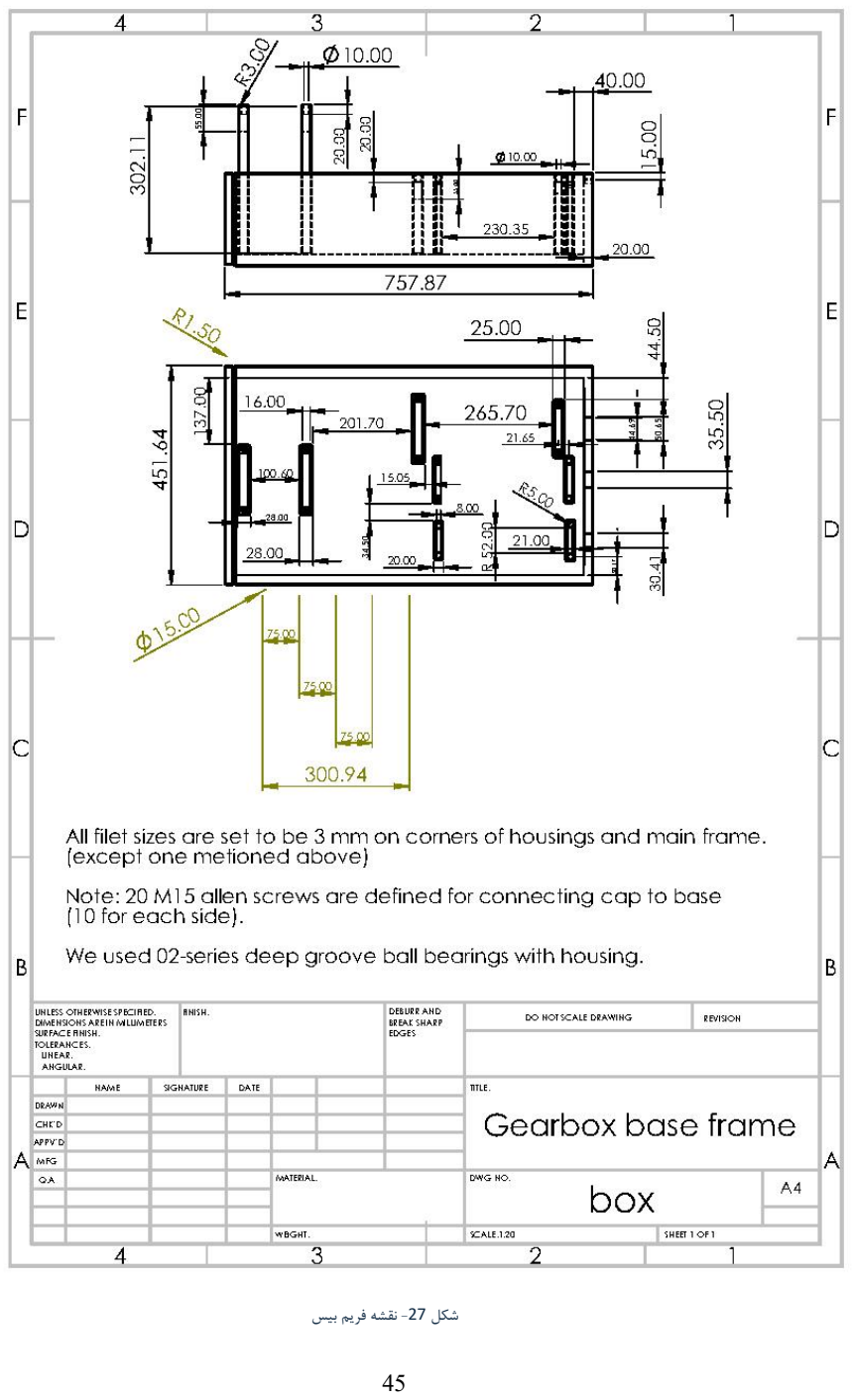
[picture p23: page 45]

شکل -27 نقشه فریم بیس

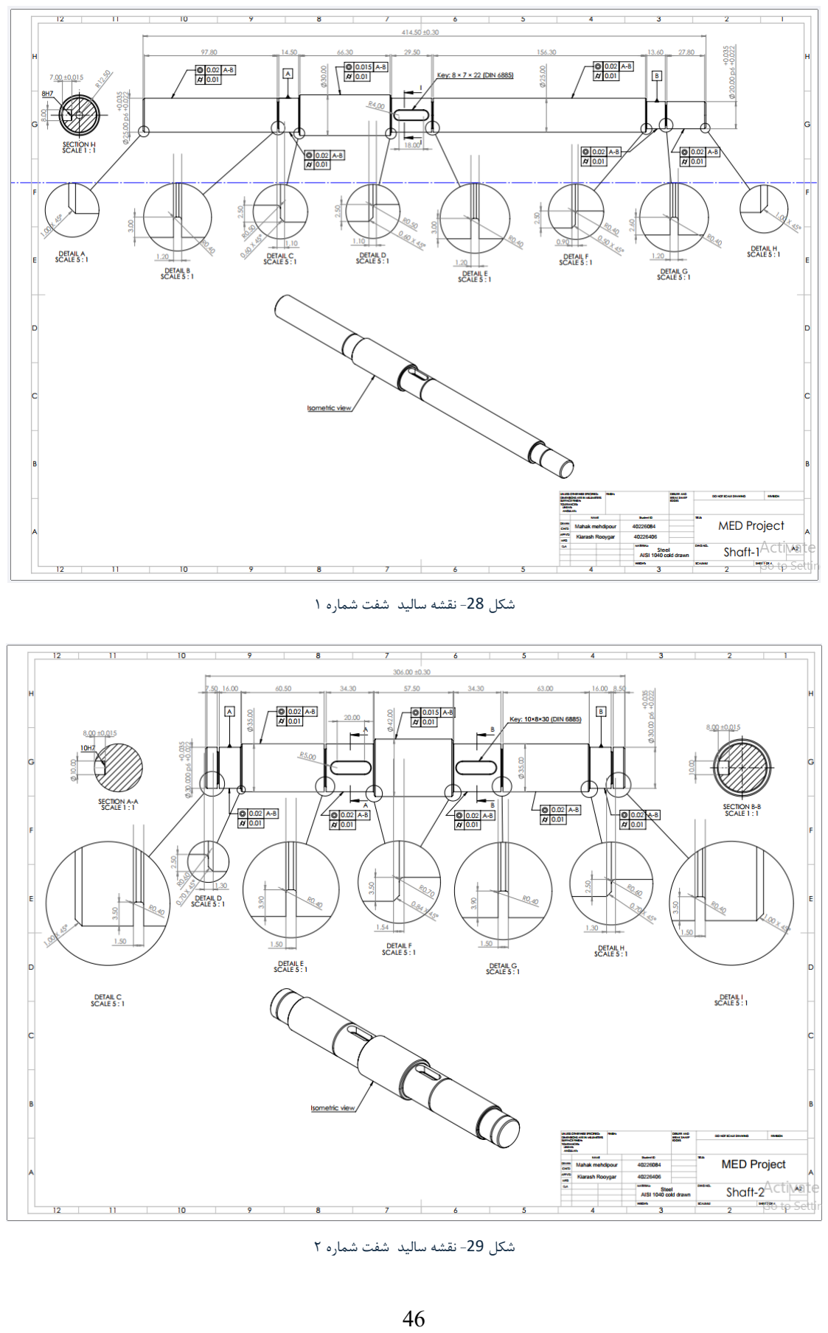
[picture p24: page 46]

شکل -28 نقشه سالید شفت شماره 1

شکل -29 نقشه سالید شفت شماره 2

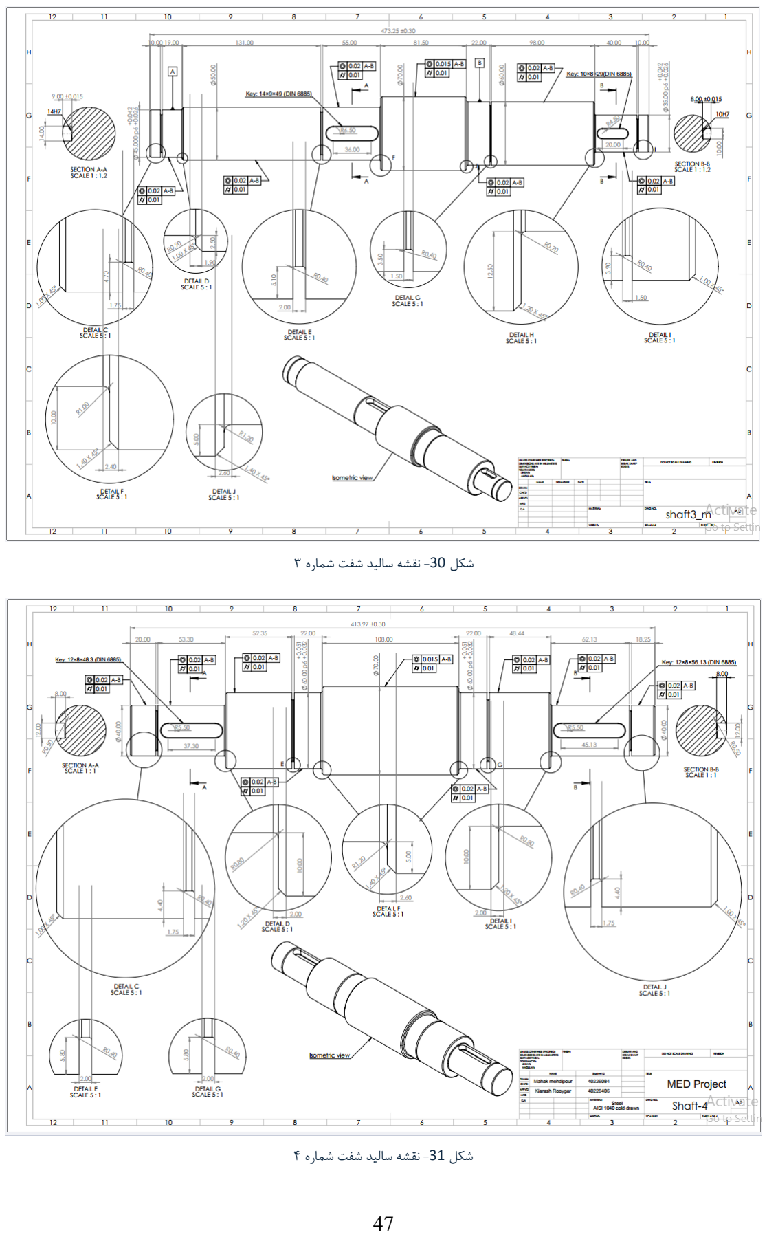
[picture p25: page 47]

شکل -30 نقشه سالید شفت شماره ۳

شکل -31 نقشه سالید شفت شماره 4

تلرانس گذاری

تلرانسگذاری در طراحی و ساخت شفتها یک پل ارتباطی بین محاسبات مهندسی و ساخت شفت و برش ها در کارگاه تراشکاری است. هیچ دستگاهی نمیتواند قطعهای را دقیقاً با همان عددی که در نقشه نوشته شده تولید کند.
8 | در طراحی اجزای دوار ماشینآالت، به ویژه شفتهای انتقال قدرت، اکتفا کردن به تلرانسهای ابعادی
به تنهایی برای تضمین
عملکرد صحیح کافی نیست. تلرانسهای ابعادی تنها اندازه قطعه را کنترل میکنند، اما شکلی که قطعه در آن فضا اشغال میکند )مانند گردی، استوانهای بودن و را ستانی محور( را تضمین نمیکنند . شفتها قطعاتی با سرعت دوران باال هستند. هرگونه انحراف از
9 | محور مرکزی
یا خمیدگی در طول شفت، باعث ایجاد لنگی میشود. بدون کنترل هندسی، این لنگی منجر به ایجاد نیروهای گریز
10در شفت می | از مرکز نامتقارن، لرزشهای شدید، سر و صدا و در نهایت خستگی
شود.

برای تلرانس گذاری در طراحی شفت ها از استاندارد Iso استفاده شده است.

نشیمنگاه بیرینگ و چرخدنده ها

در تمامی شفت ها در محل قرارگیری بیرینگ ها به دلیل انطباق پرسی این اجزا تلورانس 6P7/H انتخاب شده. در اکثر کاربردها، شفت میچرخد و بار وارده به یاتاقان ثابت است. اگر انطباق شل باشد، حلقه داخلی بلبرینگ نسبت به شفت کمی جابهجا میشود. این جابهجایی کوچک باعث ایجاد اصطکاک، تولید گرما و در نهایت جوش خوردن سرد یا ساییدگی شدید شفت میشود. انطباق 6p فشار کافی برای قفل کردن حلقه روی شفت را ایجاد میکند.

در تمامی شفت ها در محل قرارگیری چرخدنده ها تلورانس 6n7/H در نظر گرفته شده. چرخدندهها برای اینکه نرم کار کنند و صدا ندهند ، باید دقیقاً با محور شفت هممرکز باشند. تلرانس 6n یک تداخل جزئی ایجاد میکند که باعث میشود چرخدنده هیچگونه لقی شعاعی نداشته باشد. برخالف 6P که خیلی سفت است، 6n اجازه میدهد قطعه با دقت باال سانتر شود بدون اینکه تنش پسماند زیادی در چرخدنده ایجاد کند .

جاخار مستطیلی

در تمامی شفت ها جهت انتقال گشتاور در محل اتصال چرخدندهها، تلرانس عرضی جاخار بر روی شفت برابر با 9P تعیین شده است. این انتخاب به دلیل ایجاد یک انطباق سفت با خار است که مانع از بروز هرگونه لقی در اثر تغییر جهت گشتاور یا بارهای ضربه ای میگردد. استفاده از این تلرانس ، موجب توزیع یکنواخت تنش بر دیوارههای جاخار شده و از پدیده شکست در اثر خستگی درخار و تغییر فرم جای خار جلوگیری میکند.

8 Dimensional Tolerances
9 Eccentricity
10 fatigue

تلرانس هندسی

برای نشیمنگاههای یاتاقان ها که به عنوان مراجع اصلی کل شفت عمل میکنند، تلرانس هممحوری لحاظ شده است. این امر از بروز ارتعاشات غیرمجاز در سرعتهای نامی و اعمال بارهای اضافی شعاعی به بیرینگ جلوگیری میکند. همچنین، برای محل قرارگیری چر خدنده ها، تلرانس لنگی دایرهای تعیین شده است تا از درگیری صحیح دندانهها و ثا بت ماندن فاصله مرکز تا مرکز چرخ دندهها در هر دور چرخش اطمینان حاصل شود. به منظور اطمینان از تماس کامل سطح شفت با سطح داخلی بیرینگ و جلوگیری از تمرکز تنش در نقاط خاص، تلرانس استوانهای بودن برای نشیمنگاهها تعریف شده است.

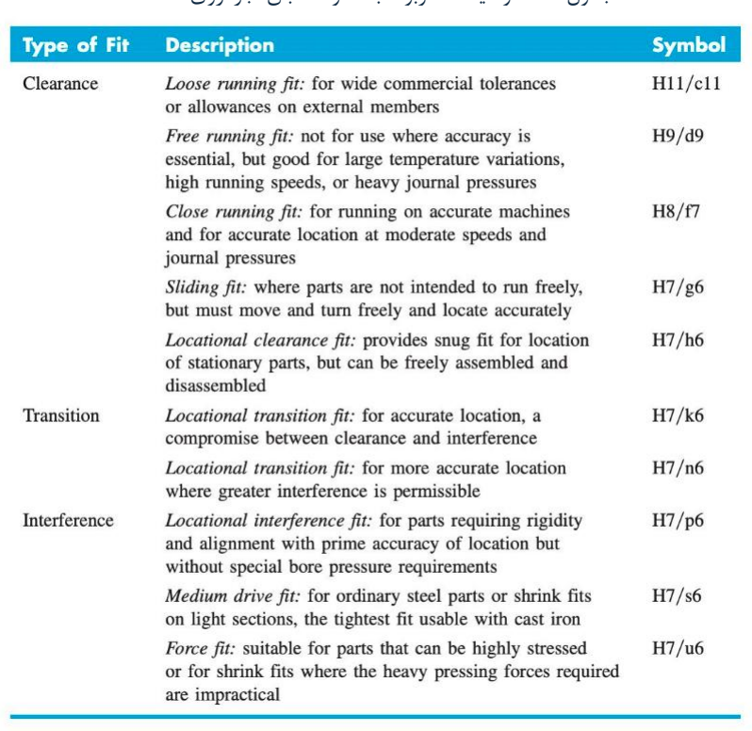
[picture p26: figure]

جدول -27 توضیحات مربوط به نحوه انطباق اجزا روی شفت

منابع و مراجع

McGraw-Hill .Shigley’s Mechanical Engineering Design .)20۱⁵( .J.K. Richard G. Budynas .Education

ولی نژاد. )1۳87(. جداول و استاندارد های طراحی و ماشین سازی.

Rolling Bearings Catalogue. SKF.
