kiarash-rgr/Two-Stage-Gearbox-Shaft-Design/solid(gearbox)/Assem1.SLDASM

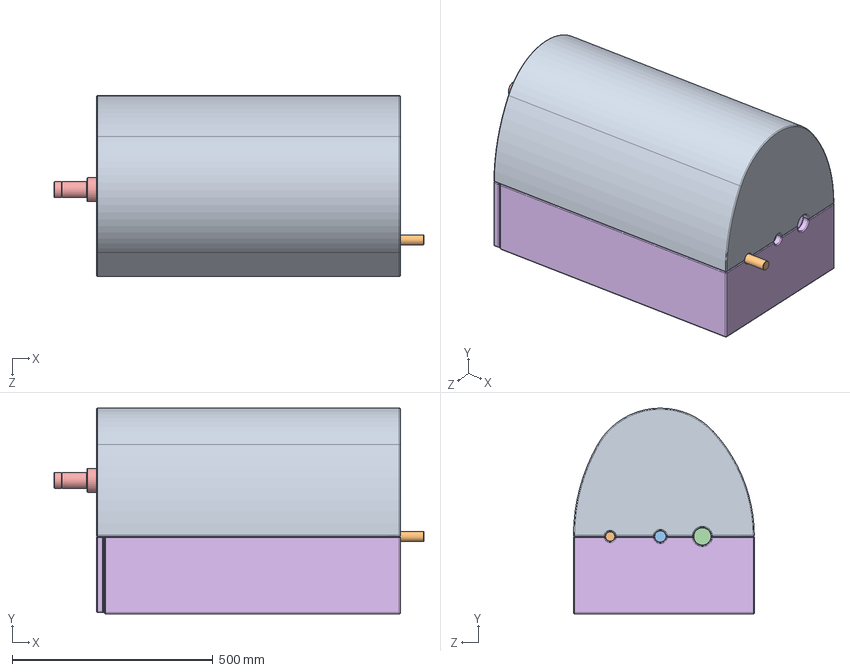
[picture p27: CAD file, 2026-06-26]
solid(gearbox)/Assem1.SLDASM
922.6 x 513.1 x 451.6 mm
shaft1_m
shaft2_m
shaft3_m
shaft4_m
box cap
