kiarash-rgr/Two-Stage-Gearbox-Shaft-Design/solid(shafts)/shaft4_m.SLDPRT

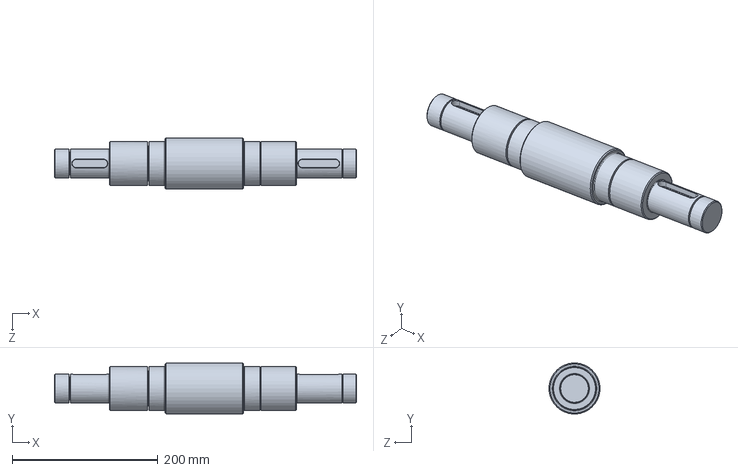
[picture p28: CAD file, 2026-06-26]
solid(shafts)/shaft4_m.SLDPRT
414.0 x 69.8 x 70.0 mm
