kiarash-rgr/Two-Stage-Gearbox-Shaft-Design/solid(gearbox)/box cap.SLDPRT

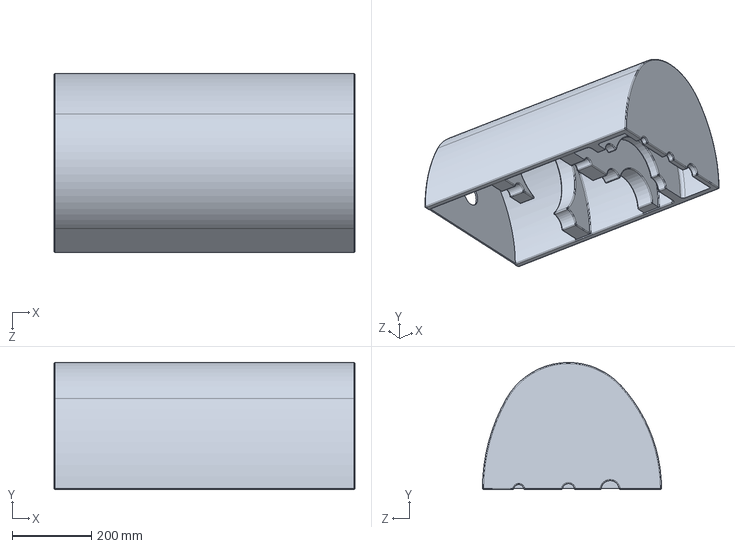
[picture p29: CAD file, 2026-06-26]
solid(gearbox)/box cap.SLDPRT
757.9 x 320.0 x 451.1 mm
