kiarash-rgr/Two-Stage-Gearbox-Shaft-Design/solid(shafts)/shaft3_m.SLDPRT

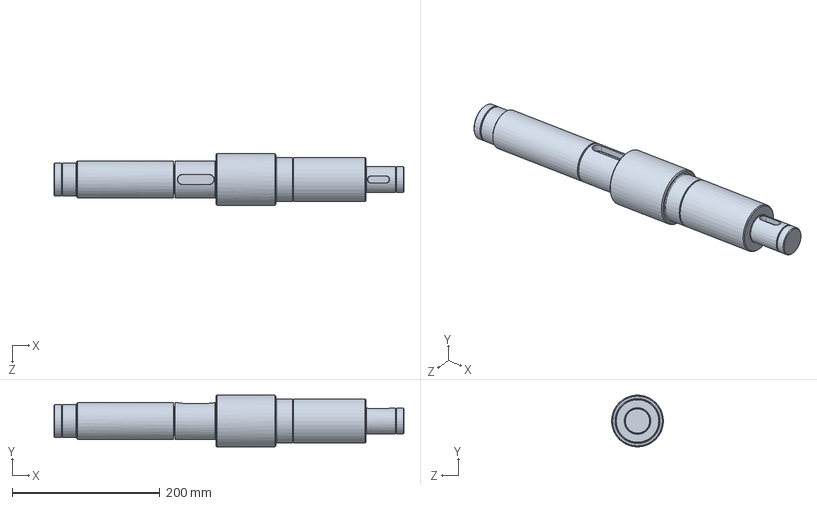
[picture p30: CAD file, 2026-06-26]
solid(shafts)/shaft3_m.SLDPRT
473.2 x 69.9 x 70.0 mm
