kiarash-rgr/Two-Stage-Gearbox-Shaft-Design/solid(gearbox)/box.SLDPRT

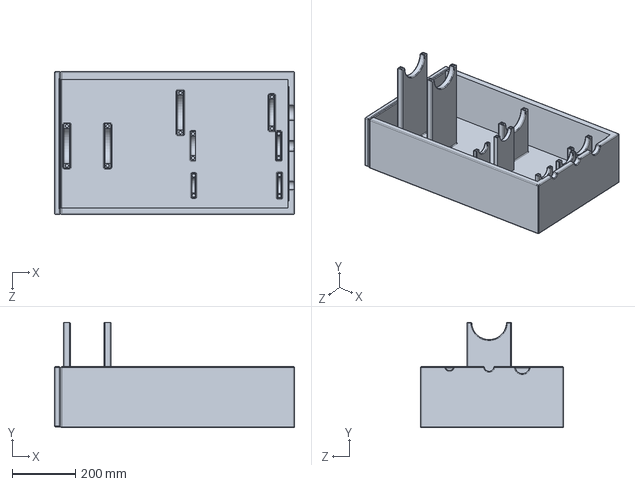
[picture p31: CAD file, 2026-06-26]
solid(gearbox)/box.SLDPRT
757.9 x 333.1 x 451.6 mm
