kiarash-rgr/Two-Stage-Gearbox-Shaft-Design/solid(shafts)/shaft1_m.SLDPRT

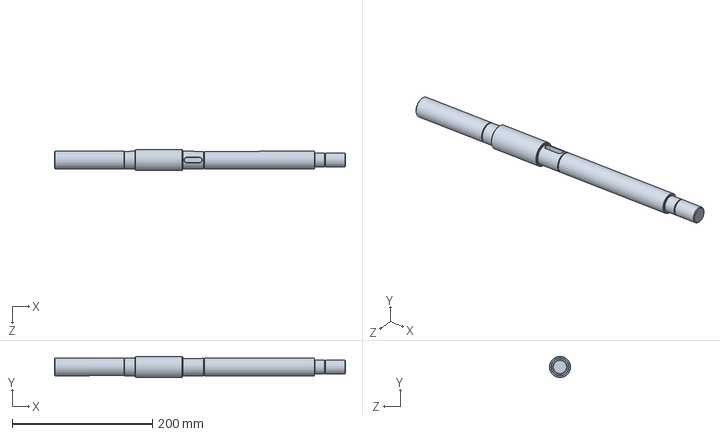
[picture p32: CAD file, 2026-06-26]
solid(shafts)/shaft1_m.SLDPRT
414.5 x 30.0 x 30.0 mm
