kiarash-rgr/Two-Stage-Gearbox-Shaft-Design/solid(shafts)/shaft2_m.SLDPRT

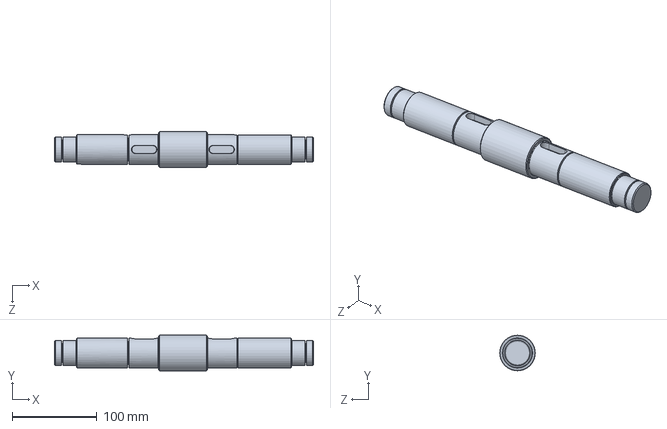
[picture p33: CAD file, 2026-06-26]
solid(shafts)/shaft2_m.SLDPRT
306.0 x 42.0 x 42.0 mm
