kiarash-rgr/Two-Stage-Gearbox-Shaft-Design/(list of files, cad)

Other CAD files:
solid(gearbox)/Gearbox Case.SLDDRW
solid(gearbox)/box cap.SLDDRW
solid(gearbox)/box.SLDDRW
solid(shafts)/shaft1_m2022.SLDDRW
solid(shafts)/shaft2_2022.SLDDRW
solid(shafts)/shaft3_2022.SLDDRW
solid(shafts)/shaft4_2022.SLDDRW
