kiarash-rgr/Two-Stage-Gearbox-Shaft-Design/solid(shafts)/shaft3_m.pdf

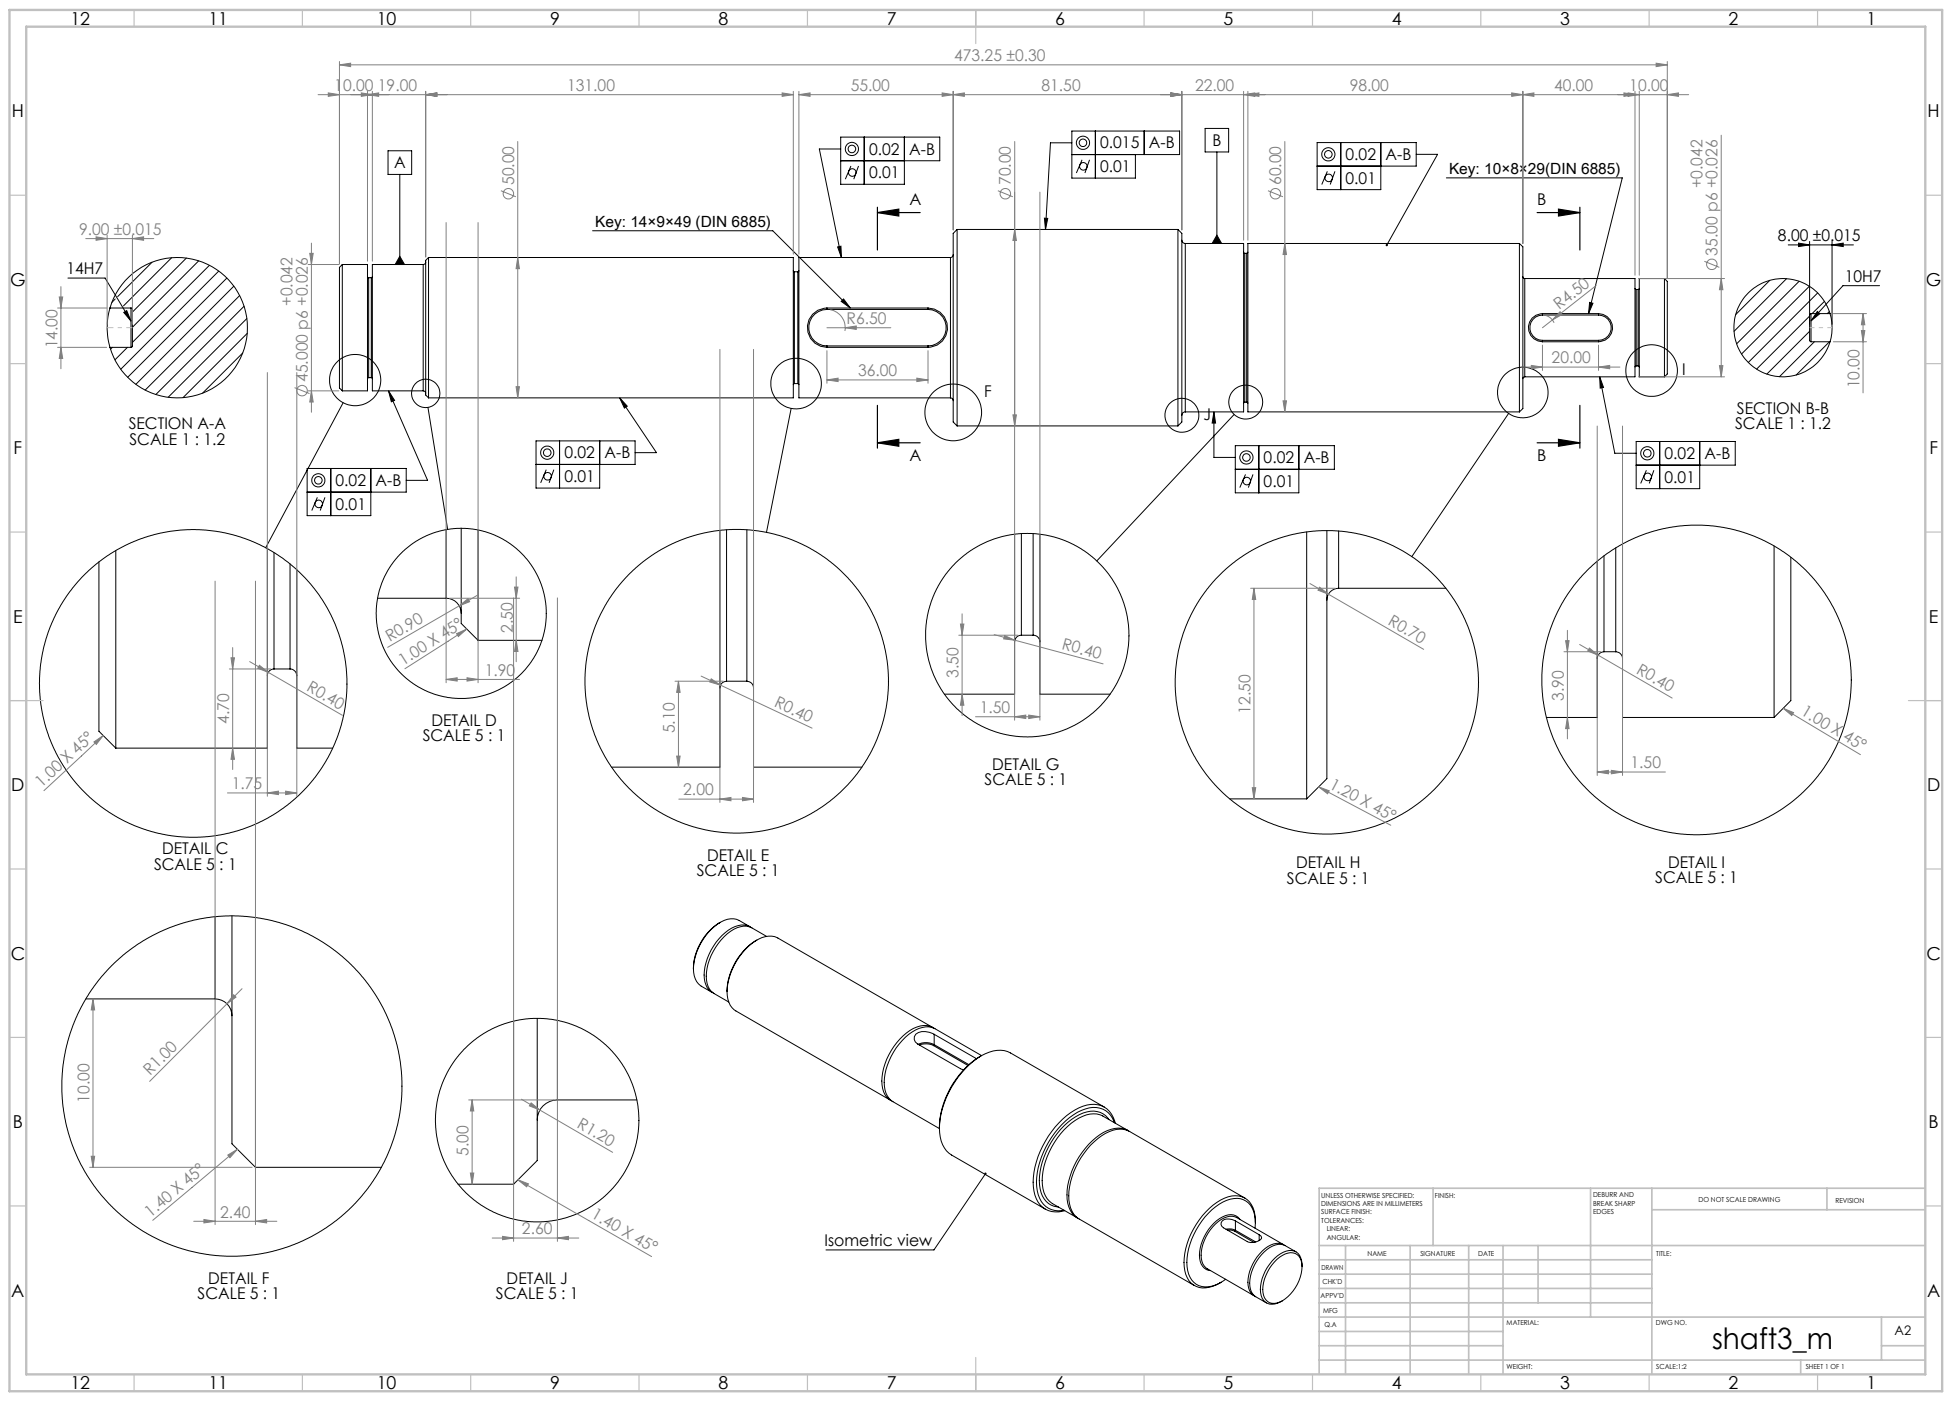
[picture p34: page 1]
Key: 14×9×49 (DIN 6885); Key: 10×8×29(DIN 6885); SECTION A-A SCALE 1 : 1.2; SECTION B-B SCALE 1 : 1.2; DETAIL C SCALE 5 : 1; DETAIL D SCALE 5 : 1; DETAIL E SCALE 5 : 1; DETAIL F SCALE 5 : 1; DETAIL G SCALE 5 : 1; DETAIL H SCALE 5 : 1; DETAIL I SCALE 5 : 1; Isometric view; DETAIL J A; SCALE 5 : 1; FINISH:; DEBURR AND; BREAK SHARP; DO NOT SCALE DRAWING; REVISION; SCALE:1:2; SHEET 1 OF 1

UNLESS OTHERWISE SPECIFIED:
DIMENSIONS ARE IN MILLIMETERS
SURFACE FINISH:
TOLERANCES:
LINEAR:
ANGULAR:

NAME | SIGNATURE | DATE | | | | TITLE:

DRAWN
CHK'D
APPV'D
MFG
Q.A | | | | MATERIAL: | DWG NO. shaft3_m | A2
