kiarash-rgr/Two-Stage-Gearbox-Shaft-Design/solid(shafts)/shaft1_m.pdf

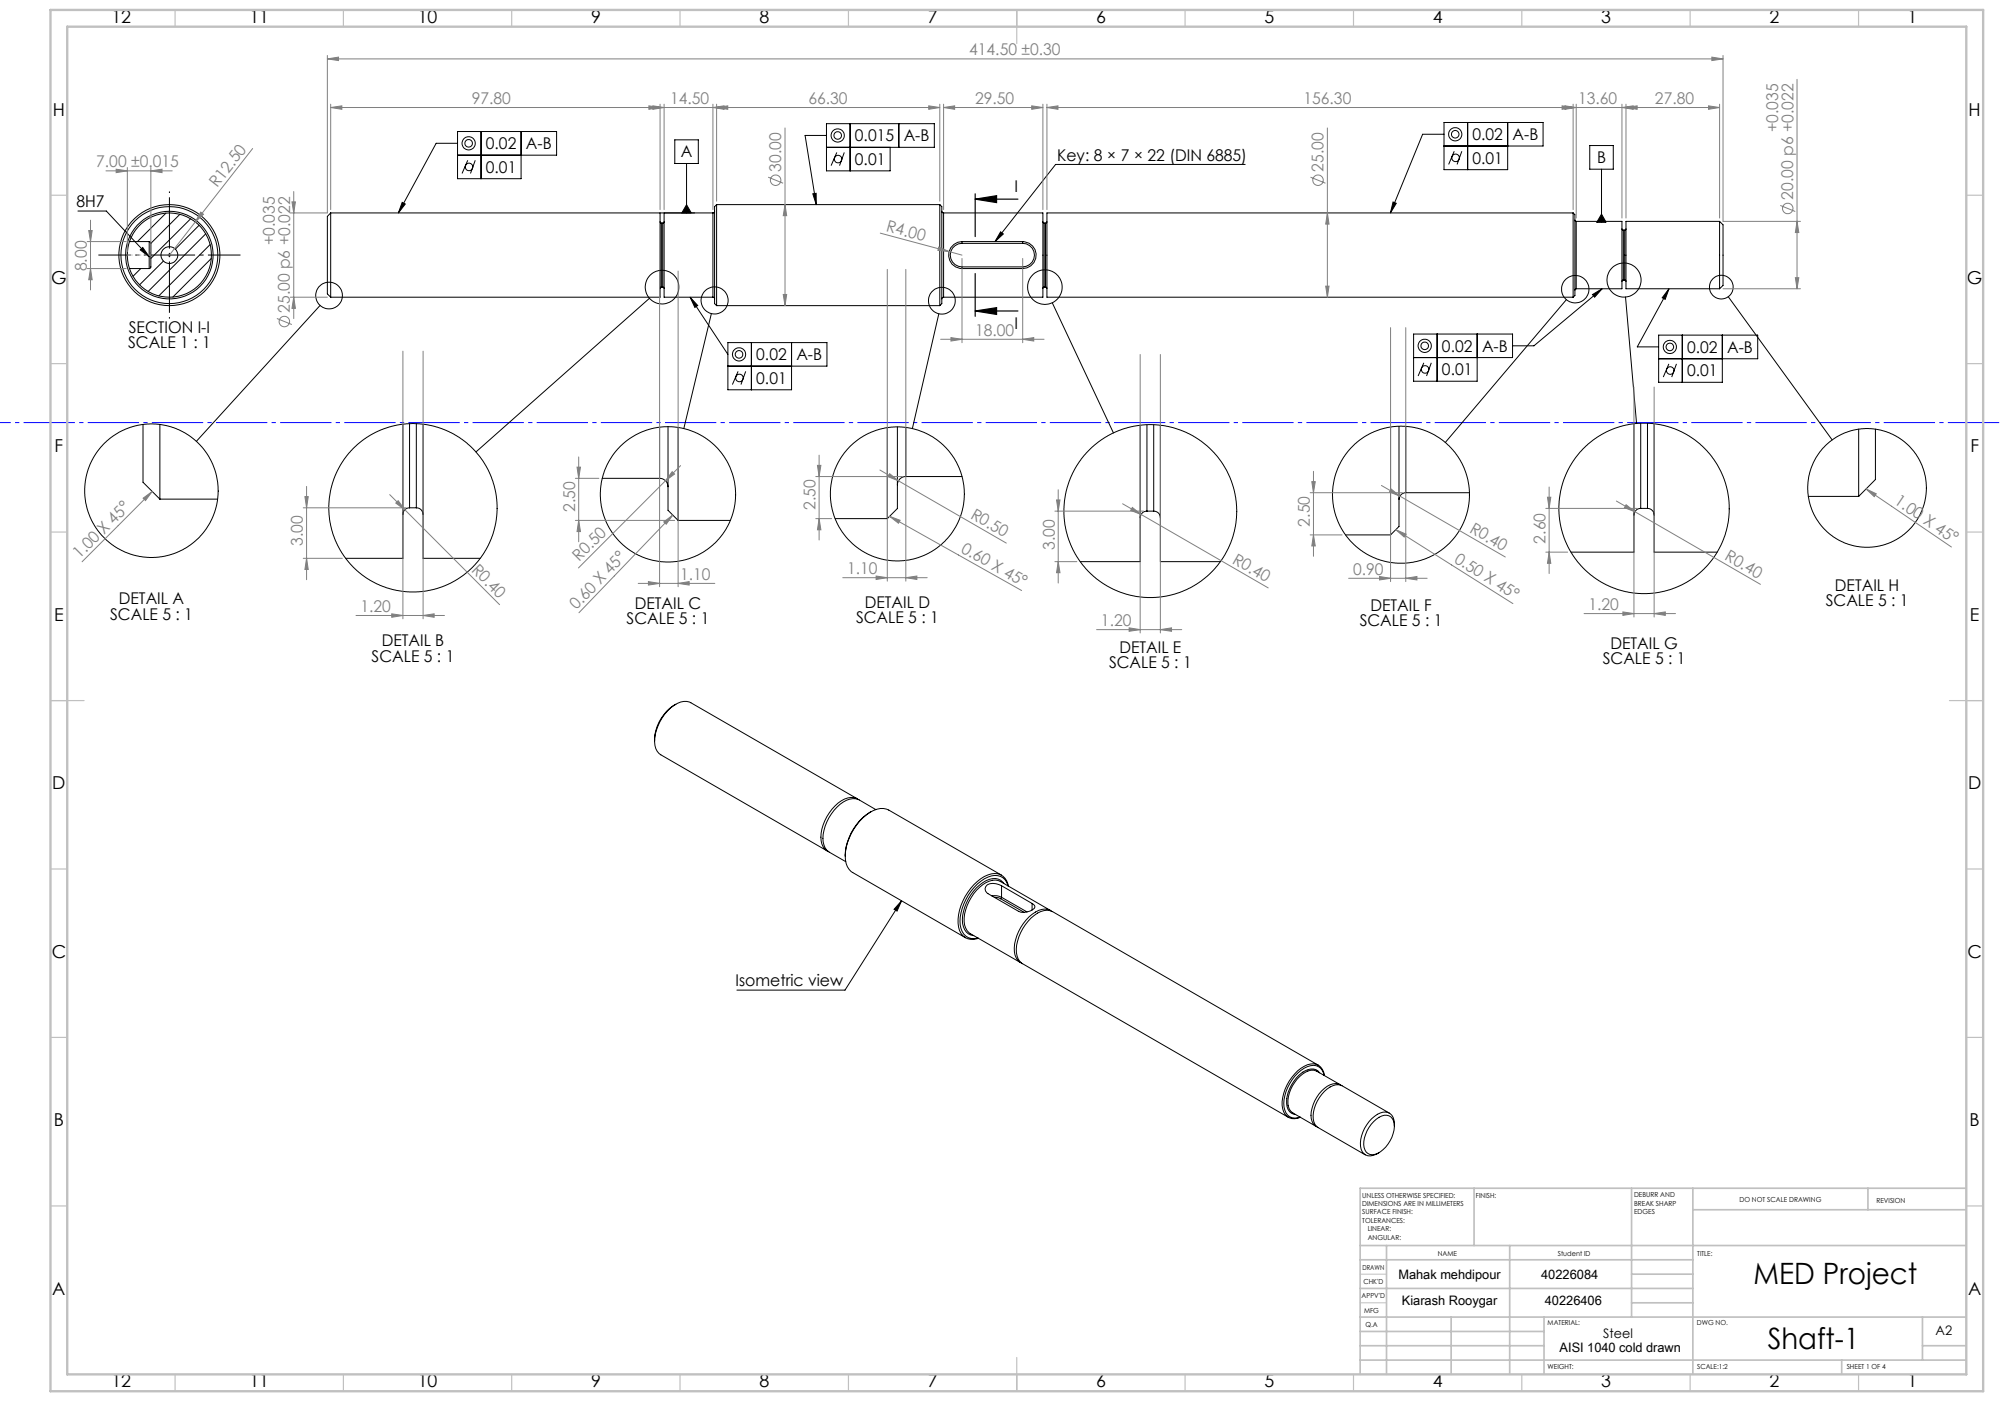
[picture p35: page 1]
Key: 8 × 7 × 22 (DIN 6885); DETAIL A SCALE 5 : 1; DETAIL B SCALE 5 : 1; DETAIL C SCALE 5 : 1; DETAIL D; SCALE 5 : 1; DETAIL E SCALE 5 : 1; DETAIL F SCALE 5 : 1; DETAIL G SCALE 5 : 1; DETAIL H SCALE 5 : 1; SECTION I-I SCALE 1 : 1; Isometric view; DWG NO.; SCALE:1:2; SHEET 1 OF 4; AISI 1040 cold drawn; Kiarash Rooygar; MED Project A

UNLESS OTHERWISE SPECIFIED: DIMENSIONS ARE IN MILLIMETERS SURFACE FINISH: TOLERANCES: LINEAR: ANGULAR: | FINISH: | DEBURR AND BREAK SHARP EDGES | DO NOT SCALE DRAWING | REVISION

NAME | Student ID | TITLE:

DRAWN | Mahak mehdipour | 40226084
