kiarash-rgr/Two-Stage-Gearbox-Shaft-Design/solid(shafts)/shaft2.pdf

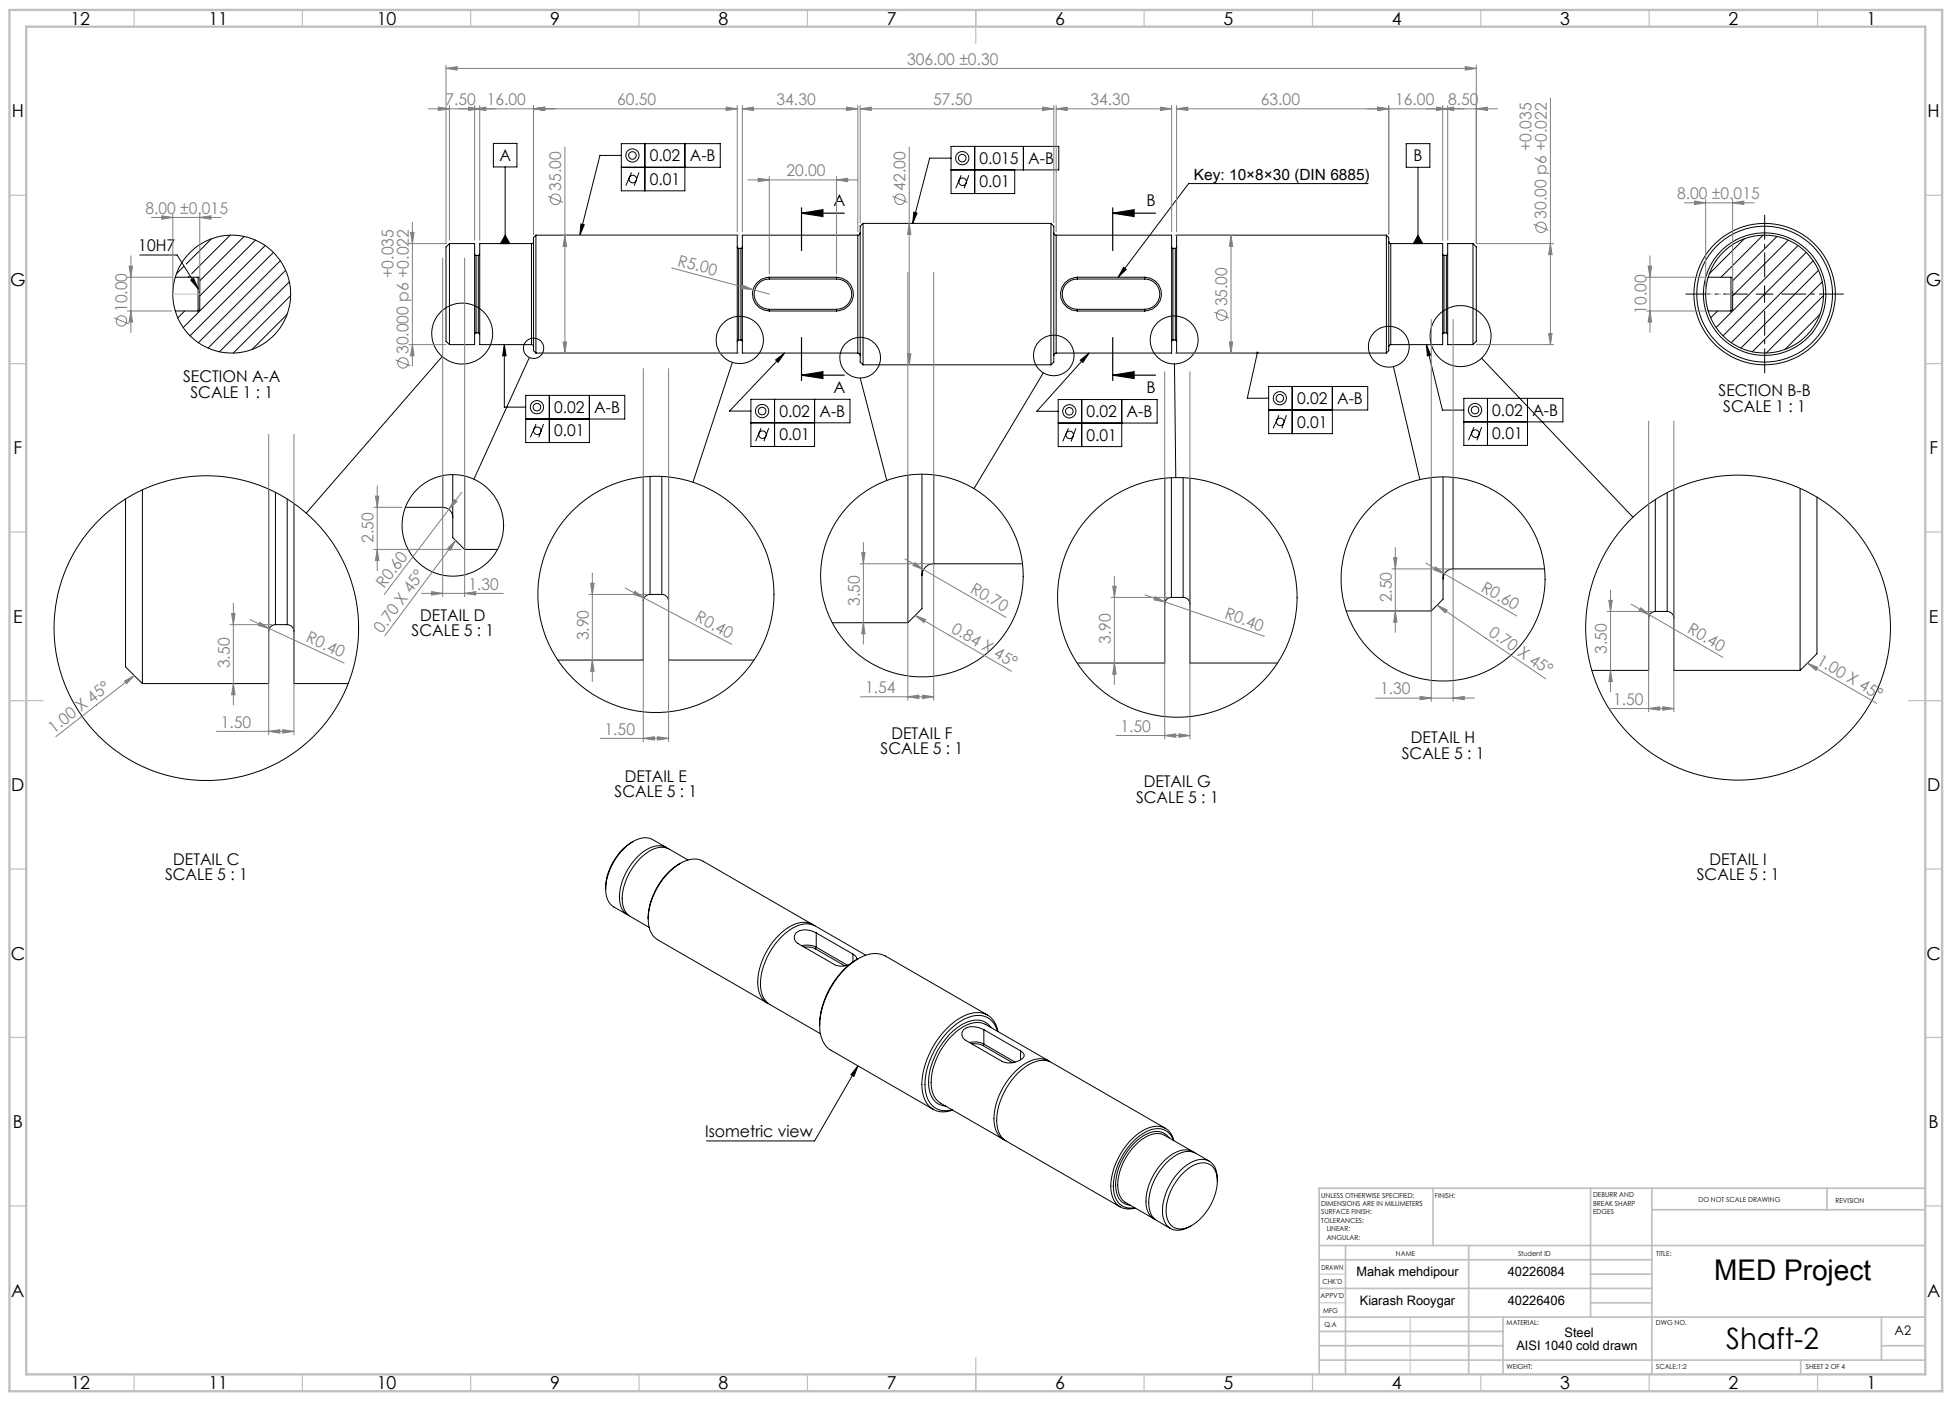
[picture p36: page 1]
Key: 10×8×30 (DIN 6885); SECTION A-A SCALE 1 : 1; SECTION B-B SCALE 1 : 1; DETAIL C SCALE 5 : 1; DETAIL D SCALE 5 : 1; DETAIL E SCALE 5 : 1; DETAIL F SCALE 5 : 1; DETAIL G SCALE 5 : 1; DETAIL H SCALE 5 : 1; DETAIL I SCALE 5 : 1; Isometric view; DWG NO.; SCALE:1:2; SHEET 2 OF 4; AISI 1040 cold drawn; Kiarash Rooygar

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

NAME | Student ID | TITLE: MED Project

DRAWN | Mahak mehdipour | 40226084
