kiarash-rgr/Two-Stage-Gearbox-Shaft-Design/solid(shafts)/shaft4_m.pdf

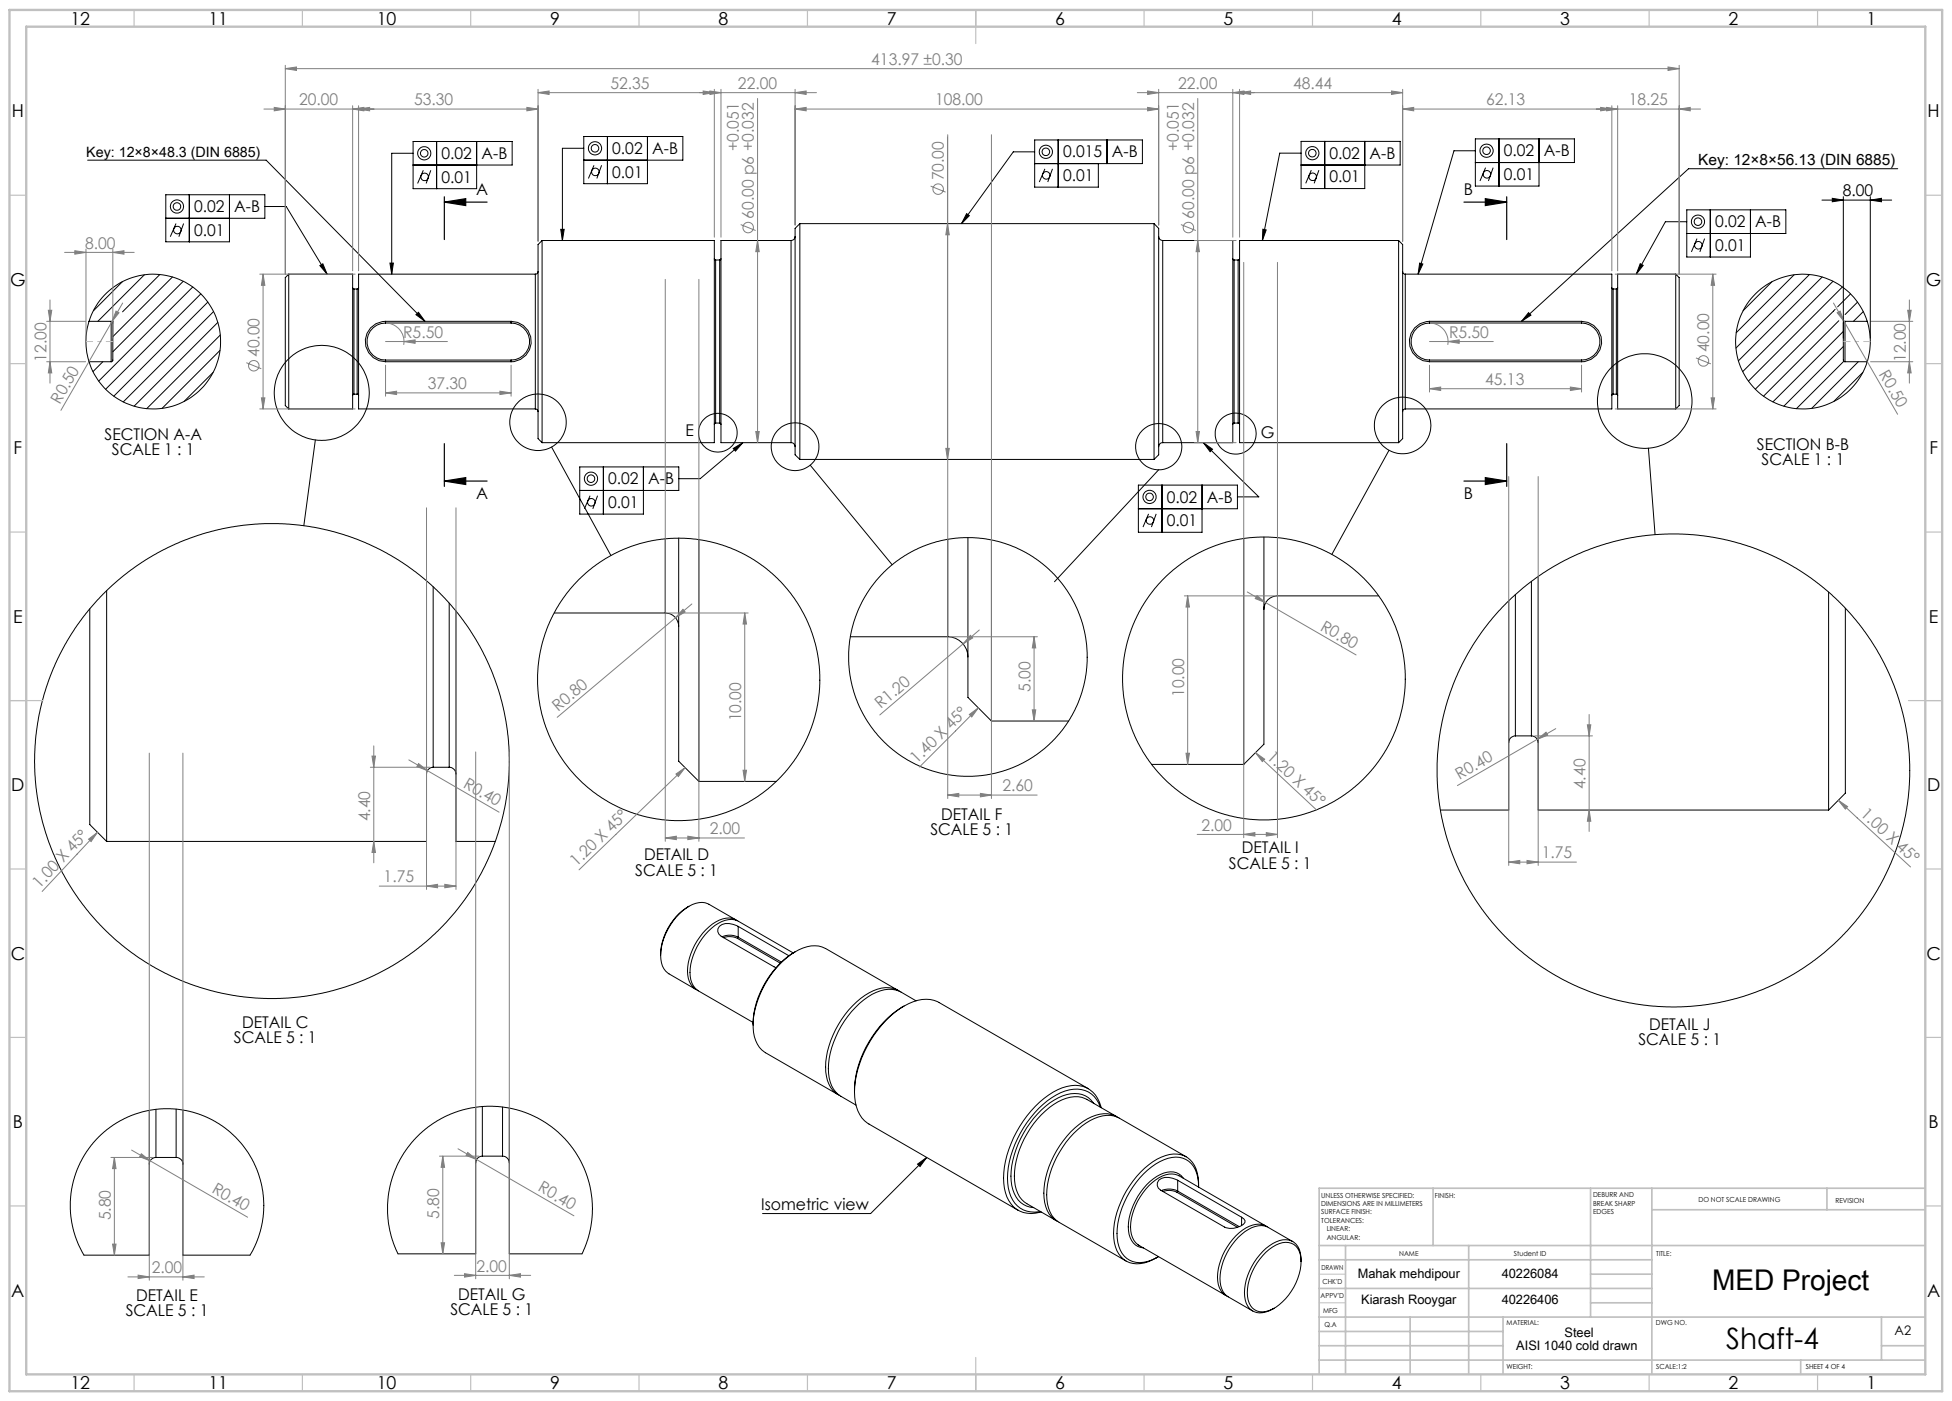
[picture p37: page 1]
Key: 12×8×48.3 (DIN 6885); Key: 12×8×56.13 (DIN 6885); SECTION A-A SCALE 1 : 1; SECTION B-B SCALE 1 : 1; DETAIL C SCALE 5 : 1; DETAIL D SCALE 5 : 1; DETAIL E SCALE 5 : 1; DETAIL F SCALE 5 : 1; DETAIL G SCALE 5 : 1; DETAIL I; SCALE 5 : 1; DETAIL J SCALE 5 : 1; Isometric view; FINISH:; DEBURR AND; BREAK SHARP; DO NOT SCALE DRAWING; REVISION; DWG NO.; SCALE:1:2; SHEET 4 OF 4; AISI 1040 cold drawn; Kiarash Rooygar

UNLESS OTHERWISE SPECIFIED:
DIMENSIONS ARE IN MILLIMETERS
SURFACE FINISH:
TOLERANCES:
LINEAR:
ANGULAR:

NAME | Student ID | TITLE: MED Project

DRAWN | Mahak mehdipour | 40226084
